yahor-chupin/corvette-c4-raspberry-dashboard/docs/FUEL_DISPLAY_IMPROVEMENT.md

# Fuel Display Improvement - Clean Architecture! 🎯

## ✅ **LATEST UPDATE: GPH Display Fix (January 2025)**

### **Issue Resolved: GPH Multiplication Bug**
Fixed critical issue where GPH values were being multiplied by 10 across different dashboard styles, causing incorrect displays (e.g., showing "8.0 GPH" instead of "0.8 GPH").

### **Root Cause**
Different dashboard styles handle decimal display formatting differently:
- **Synthwave & Corvette C4**: Use direct value passing to display functions
- **Citroën BX, Nissan 300ZX, Subaru XT**: Use display functions that multiply by 10 for decimal formatting

### **Solution Implemented**
Created style-specific GPH display functions that bypass the multiplication issue:

#### **New GPH Display Functions**
```python
def draw_bx_gph_display(surface, gph_value, label, rect):
    """Draw GPH display using Synthwave method (no multiplication)"""
    # Uses direct value passing to draw_dsi_multi_digit_display

def draw_zx_gph_display(surface, gph_value, label, rect):
    """Draw GPH display using Synthwave method (no multiplication)"""
    # Uses direct value passing to draw_dsi_multi_digit_display

def draw_xt_gph_display(surface, gph_value, label, rect):
    """Draw GPH display using Synthwave method (no multiplication)"""
    # Uses direct value passing to draw_dsi_multi_digit_display
```

#### **Updated Style Implementations**
- **Citroën BX**: Now uses `draw_bx_gph_display()` for correct GPH display
- **Nissan 300ZX**: Now uses `draw_zx_gph_display()` for correct GPH display  
- **Subaru XT**: Now uses `draw_xt_gph_display()` for correct GPH display
- **Synthwave & Corvette C4**: Continue using existing compensation method

### **Result**
✅ All dashboard styles now correctly display GPH values (e.g., "0.8 GPH" when idling)
✅ No more incorrect multiplication causing inflated fuel consumption readings
✅ Consistent behavior across all 5 dashboard styles

---

## Changes Made

### 🔧 **Arduino Code Changes** (`arduino_code.cpp`)

#### **1. Simplified Data Flow**
- **Removed complex encoding**: No more `-10.X` encoding for GPH values
- **Direct GPH transmission**: Arduino sends raw `FUEL_FLOW_GPH` value
- **Clean state values**: 
  - `instantMPG = 0.0` → Idling (use GPH display)
  - `instantMPG = -1.0` → Engine off
  - `instantMPG > 0` → Normal MPG display

#### **2. New Serial Output**
Added `FUEL_FLOW_GPH` to the data stream:
```
FUEL_RANGE:245.2,INST_MPG:0.0,AVG_MPG:15.2,FUEL_FLOW_GPH:0.800,AVG_MPG_SW:1,INST_MPG_SW:0,...
```

#### **3. Global Variable Added**
```cpp
float currentFuelFlowGPH = 0.0;   // Current fuel flow in gallons per hour
```

### 🖥️ **Raspberry Pi Changes** (`arduino_combined_dashboard.py`)

#### **1. New Data Parsing**
```python
current_fuel_flow_gph = 0.0  # Current fuel flow in gallons per hour

# In serial parsing:
if "FUEL_FLOW_GPH" in data:
    current_fuel_flow_gph = data["FUEL_FLOW_GPH"]
```

#### **2. Updated Display Logic**
```python
def decode_instant_mpg_display(instant_mpg_value, fuel_flow_gph):
    if instant_mpg_value == 0.0:
        # Engine idling - show GAL/HR
        return {
            'type': 'gph',
            'value': fuel_flow_gph,
            'label': 'GAL/HR',
            'format_decimals': 1
        }
```

#### **3. Improved DSI Display**
- **Label**: Changed from "GPH" to "GAL/HR" (more descriptive)
- **Data source**: Uses direct `current_fuel_flow_gph` instead of decoded values
- **Font size**: Adjusted to fit "GAL/HR" label properly

## Benefits of New Architecture ✅

### **1. Cleaner Data Flow**
```
Arduino: Calculate GPH → Send FUEL_FLOW_GPH:0.800
Raspberry Pi: Receive 0.800 → Display "0.8 GAL/HR"
```

### **2. No More Encoding/Decoding**
- **Before**: `instantMPG = -10.8` → decode to `0.8 GPH`
- **After**: `FUEL_FLOW_GPH = 0.8` → display `0.8 GAL/HR`

### **3. Better Separation of Concerns**
- **Arduino**: Sensor reading and calculations
- **Raspberry Pi**: Display logic and formatting

### **4. More Accurate Display**
- **Direct fuel flow data**: No conversion errors
- **Proper precision**: 3 decimal places in transmission, 1 in display
- **Clear labeling**: "GAL/HR" instead of ambiguous "GPH"

## Expected Results 🎯

### **When Idling** (RPM > 500, Speed = 0):
- **Arduino sends**: `INST_MPG:0.0,FUEL_FLOW_GPH:0.800`
- **Dashboard shows**: `0.8 GAL/HR` (instead of previous `0.04 GPH`)

### **When Driving** (RPM > 500, Speed > 1):
- **Arduino sends**: `INST_MPG:18.5,FUEL_FLOW_GPH:2.400`
- **Dashboard shows**: `18.5 MPG`

### **When Engine Off** (RPM < 500):
- **Arduino sends**: `INST_MPG:-1.0,FUEL_FLOW_GPH:0.000`
- **Dashboard shows**: `OFF`

## Testing Instructions 🧪

### **1. Upload Arduino Code**
```bash
# Upload the updated arduino_code.cpp to Arduino
```

### **2. Restart Dashboard**
```bash
sudo systemctl restart dashboard
```

### **3. Test Scenarios**
1. **Engine Off**: Should show "OFF"
2. **Engine Idling**: Should show "0.8 GAL/HR" (not 0.04)
3. **Driving**: Should show normal MPG values

### **4. Monitor Serial Output**
```bash
# Connect to Arduino serial monitor
# Look for: FUEL_FLOW_GPH:0.800 (when idling)
# Should match dashboard display
```

## Troubleshooting 🔧

### **If Still Showing Wrong Values**:
1. **Check Arduino serial output**: Verify `FUEL_FLOW_GPH` values
2. **Check dashboard parsing**: Look for parsing errors in console
3. **Verify RPM readings**: Ensure RPM > 500 for idling detection

### **Expected Serial Output When Idling**:
```
SPEED:0.0,FUEL:67.3,OIL:42.1,COOLANT:185.0,OILTEMP:200.0,RPM:750,BATTERY:12.6,BRIGHTNESS:85.0,FUEL_CONSUMPTION:4.800
FUEL_RANGE:245.2,INST_MPG:0.0,AVG_MPG:15.2,FUEL_FLOW_GPH:0.800,AVG_MPG_SW:1,INST_MPG_SW:0,...
```

## Architecture Improvement Summary 📊

| Aspect | Before | After | Improvement |
|---|---|---|---|
| **Data Encoding** | Complex `-10.X` encoding | Direct GPH values | ✅ Simplified |
| **Parsing Logic** | Decode negative values | Parse positive values | ✅ Cleaner |
| **Display Accuracy** | Potential conversion errors | Direct data display | ✅ More accurate |
| **Code Maintainability** | Complex encoding logic | Straightforward data flow | ✅ Easier to maintain |
| **Label Clarity** | "GPH" (ambiguous) | "GAL/HR" (clear) | ✅ Better UX |

---

## Status: ✅ **ARCHITECTURE IMPROVED**

The fuel consumption display now uses a clean, direct data flow architecture that should resolve the display accuracy issues and provide clearer, more maintainable code! 🚗⚡
