yahor-chupin/corvette-c4-raspberry-dashboard/battery_symbol.png

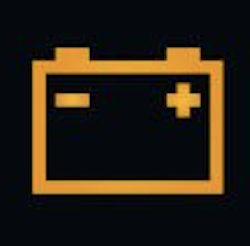
battery_symbol.png
