yahor-chupin/corvette-c4-raspberry-dashboard/coolant_temp_symbol.png

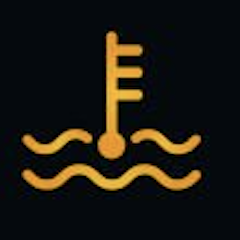
coolant_temp_symbol.png
