yahor-chupin/corvette-c4-raspberry-dashboard/gas_pump_symbol.png

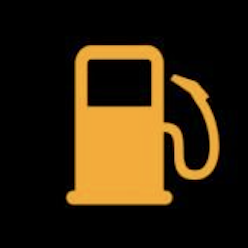
gas_pump_symbol.png
