yahor-chupin/corvette-c4-raspberry-dashboard/oil_symbol.png

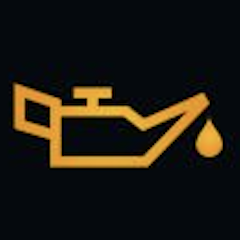
oil_symbol.png
