yahor-chupin/corvette-c4-raspberry-dashboard/arduino_combined_dashboard.py

import pygame
import serial
import math
import time
import os
import subprocess
import json
import signal
import sys
from datetime import datetime

print("THIS IS A DEBUG MESSAGE 1")
# Remove window positioning to match temp_debug_with_grid.py
# os.environ['SDL_VIDEO_WINDOW_POS'] = '-1024,0'  # DISABLED - was preventing center screen access

# Configure SDL for Raspberry Pi displays
os.environ['DISPLAY'] = ':0'  # Use X11 display
os.environ['SDL_VIDEODRIVER'] = 'x11'  # Use X11 for multi-head support

pygame.init()
pygame.mixer.quit()  # Disable audio to stop ALSA errors

# Extended window to include all three screens side by side
TOTAL_WIDTH = 5000  # Increased width to prevent tachometer clipping
SCREEN_HEIGHT = 768  # Keep original height (DSI is 480 but we'll handle rotation)
SINGLE_SCREEN_WIDTH = 1024

# Dashboard style system
current_style_index = 0
STYLE_SYNTHWAVE = 0
STYLE_CITROEN_BX = 1
STYLE_SUBARU_XT = 2
STYLE_NISSAN_300ZX = 3
STYLE_CORVETTE_C4 = 4

# Citroën BX style colors (futuristic dark green)
BX_GREEN = (0, 255, 100)      # Bright futuristic green
BX_DARK_GREEN = (0, 150, 60)  # Darker green for backgrounds
BX_DIM_GREEN = (0, 100, 40)   # Dimmed green for inactive elements
BX_BLACK = (0, 20, 10)        # Very dark green-tinted black

# Subaru XT style colors (amber/orange theme)
XT_AMBER = (255, 191, 0)       # Bright amber
XT_DARK_AMBER = (200, 120, 0)  # Darker amber for backgrounds
XT_DIM_AMBER = (150, 90, 0)    # Dimmed amber for inactive elements
XT_BLACK = (20, 15, 0)         # Very dark amber-tinted black

# Nissan 300ZX style colors (futuristic glowing turquoise theme)
ZX_BLACK = (0, 10, 15)        # Dark blue-tinted black background
ZX_TURQUOISE = (0, 255, 255)  # Bright glowing turquoise
ZX_BRIGHT_TURQUOISE = (100, 255, 255)  # Even brighter for active elements
ZX_DIM_TURQUOISE = (0, 150, 150)      # Dimmed turquoise for inactive elements
ZX_DARK_TURQUOISE = (0, 100, 100)     # Darker turquoise for backgrounds
DSI_SCREEN_WIDTH = 800
DSI_SCREEN_HEIGHT = 480
DSI_X_OFFSET = 2048  # DSI screen starts after both HDMI screens

# Check if fullscreen mode is requested (default to fullscreen for dashboard)
fullscreen_mode = os.environ.get('COMBINED_FULLSCREEN', '1') == '1'  # Default to '1' (fullscreen)

if fullscreen_mode:
    # Use borderless window spanning all screens at position (0,0)
    screen = pygame.display.set_mode((TOTAL_WIDTH, SCREEN_HEIGHT), pygame.NOFRAME)
    print("Combined dashboard started in BORDERLESS FULLSCREEN mode")
else:
    screen = pygame.display.set_mode((TOTAL_WIDTH, SCREEN_HEIGHT))
    print("Combined dashboard started in WINDOWED mode")
    print("Instructions: Press F11 for fullscreen")

pygame.display.set_caption("C4 Dual Dashboard - Combined")
pygame.mouse.set_visible(False)  # Hide mouse cursor for dashboard
clock = pygame.time.Clock()

# Track fullscreen state
is_fullscreen = fullscreen_mode

# Create surfaces for each dashboard (will be rotated)
speedometer_surface = pygame.Surface((1024, 768))
tachometer_surface = pygame.Surface((1024, 968))  # Increased height by 200px total for odometer space

# Load symbol images
try:
    coolant_temp_symbol = pygame.image.load("coolant_temp_symbol.png")
    oil_symbol = pygame.image.load("oil_symbol.png")
    gas_pump_symbol = pygame.image.load("gas_pump_symbol.png")
    battery_symbol = pygame.image.load("battery_symbol.png")
    print("Symbol images loaded successfully")
except Exception as e:
    print(f"Warning: Could not load symbol images: {e}")
    coolant_temp_symbol = None
    oil_symbol = None
    gas_pump_symbol = None
    battery_symbol = None

# Colors
BLACK = (0, 0, 0)
BRIGHT_GREEN = (0, 255, 0)
DULL_GREEN = (0, 100, 0)
YELLOW = (255, 255, 0)
NEON_PINK = (255, 20, 147)
NEON_CYAN = (0, 255, 255)
PURPLE = (138, 43, 226)
ORANGE = (255, 165, 0)
RED = (255, 0, 0)

# SPEEDOMETER PARAMETERS - ADJUSTED UP FOR BETTER SYNTHWAVE POSITIONING
SPEEDO_X_OFFSET = 350
SPEEDO_Y_OFFSET = 480  # Moved up for better Synthwave layout (was 550, now 480, -70px up)
SPEEDO_LENGTH = 350
SPEEDO_DIGITAL_X = 550
SPEEDO_DIGITAL_Y = 320  # Moved up for better Synthwave layout (was 390, now 320, -70px up)
SPEEDO_NUMBER_DISTANCE = 50
SPEEDO_GRID_X = 650
SPEEDO_GRID_Y = 180  # Moved up for better Synthwave layout (was 250, now 180, -70px up)

# TACHOMETER PARAMETERS - ADJUSTED FOR EXPANDED SURFACE (MOVED MORE DOWN)
TACHO_X_OFFSET = 350
TACHO_Y_OFFSET = 550  # Moved down more (was 520, now 550, +30px down)
TACHO_LENGTH = 350
TACHO_DIGITAL_X = 550
TACHO_DIGITAL_Y = 590  # Moved down more (was 560, now 590, +30px down)
TACHO_NUMBER_DISTANCE = 50
TACHO_GRID_X = 650
TACHO_GRID_Y = 430  # Moved down more (was 400, now 430, +30px down)

# Arduino Serial Configuration
SERIAL_BAUD = 115200  # 12x faster serial communication for ultra-low latency
SERIAL_TIMEOUT = 0.1  # Reliable timeout for stable connection

# Auto-detect Arduino port
def find_arduino_port():
    """Automatically find Arduino serial port"""
    import serial.tools.list_ports
    
    # Common Arduino ports to try first
    common_ports = ['/dev/ttyACM0', '/dev/ttyACM1', '/dev/ttyUSB0', '/dev/ttyUSB1']
    
    # Get all available ports
    available_ports = [port.device for port in serial.tools.list_ports.comports()]
    
    # Try common ports first
    for port in common_ports:
        if port in available_ports:
            try:
                test_ser = serial.Serial(port, SERIAL_BAUD, timeout=1)
                test_ser.close()
                print(f"Found Arduino on {port}")
                return port
            except:
                continue
    
    # Try other available ports
    for port in available_ports:
        if port not in common_ports:
            try:
                test_ser = serial.Serial(port, SERIAL_BAUD, timeout=1)
                test_ser.close()
                print(f"Found Arduino on {port}")
                return port
            except:
                continue
    
    return None

SERIAL_PORT = find_arduino_port() or '/dev/ttyACM0'  # Fallback to default

# Persistent Data Management
PERSISTENT_DATA_FILE = "corvette_persistent_data.json"

class PersistentDataManager:
    def __init__(self):
        self.data = {
            "total_odometer": 89240.5,  # Current odometer reading
            "trip_odometer": 0.0,
            "fuel_used": 0.0,
            "fuel_used_bpw": 0.0,  # Real-time fuel consumption tracking
            "dashboard_style": 0,  # 0=Synthwave, 1=Citroën BX
            "last_updated": datetime.now().isoformat(),
            "save_count": 0
        }
        self.load_data()
    
    def load_data(self):
        """Load persistent data from JSON file"""
        try:
            if os.path.exists(PERSISTENT_DATA_FILE):
                with open(PERSISTENT_DATA_FILE, 'r') as f:
                    loaded_data = json.load(f)
                    self.data.update(loaded_data)
                print(f"Loaded persistent data: Total ODO: {self.data['total_odometer']:.1f} miles, "
                      f"Trip: {self.data['trip_odometer']:.1f} miles")
            else:
                print("No existing persistent data file found, starting with defaults")
                self.save_data()
        except Exception as e:
            print(f"Error loading persistent data: {e}")
    
    def save_data(self):
        """Save persistent data to JSON file"""
        try:
            self.data["last_updated"] = datetime.now().isoformat()
            self.data["save_count"] += 1
            
            # Create backup every 1000 saves
            if self.data["save_count"] % 1000 == 0:
                backup_file = f"{PERSISTENT_DATA_FILE}.backup_{int(time.time())}"
                if os.path.exists(PERSISTENT_DATA_FILE):
                    import shutil
                    shutil.copy2(PERSISTENT_DATA_FILE, backup_file)
                    print(f"Created backup: {backup_file}")
            
            with open(PERSISTENT_DATA_FILE, 'w') as f:
                json.dump(self.data, f, indent=2)
            
        except Exception as e:
            print(f"Error saving persistent data: {e}")
    
    def update_data(self, total_odo, trip_odo, fuel_used, fuel_used_bpw=0.0):
        """Update and save persistent data"""
        # Check if data has changed significantly to avoid excessive disk writes
        odo_changed = abs(self.data["total_odometer"] - total_odo) >= 0.1  # Save if odometer changed by 0.1+ miles
        trip_changed = abs(self.data["trip_odometer"] - trip_odo) >= 0.1   # Save if trip changed by 0.1+ miles
        fuel_changed = abs(self.data["fuel_used"] - fuel_used) >= 0.01     # Save if fuel changed by 0.01+ gallons
        bpw_changed = abs(self.data["fuel_used_bpw"] - fuel_used_bpw) >= 0.01  # Save if BPW fuel changed by 0.01+ gallons
        
        # Always update the data in memory
        self.data["total_odometer"] = total_odo
        self.data["trip_odometer"] = trip_odo
        self.data["fuel_used"] = fuel_used
        self.data["fuel_used_bpw"] = fuel_used_bpw
        
        # Only save to disk if significant change occurred
        if odo_changed or trip_changed or fuel_changed or bpw_changed:
            self.save_data()
    
    def send_init_data(self, ser):
        """Send initialization data to Arduino"""
        if ser and ser.is_open:
            try:
                init_message = f"INIT_DATA:{self.data['fuel_used']:.4f},{self.data['fuel_used_bpw']:.4f}\n"
                ser.write(init_message.encode())
                # Init data sent to Arduino
                
                # Also send calculated average MPG
                total_fuel_used = self.data["fuel_used"] + self.data["fuel_used_bpw"]
                if total_fuel_used > 0.01 and self.data["trip_odometer"] > 0.01:
                    avg_mpg = self.data["trip_odometer"] / total_fuel_used
                    if avg_mpg > 50.0:
                        avg_mpg = 50.0
                    mpg_message = f"AVG_MPG_UPDATE:{avg_mpg:.1f}\n"
                    ser.write(mpg_message.encode())
                else:
                    ser.write(b"AVG_MPG_UPDATE:0.0\n")
            except Exception as e:
                print(f"Error sending init data: {e}")

# Initialize persistent data manager
persistent_data = PersistentDataManager()

# Button timing variables
button_trip_start_time = 0
button_avg_start_time = 0
button_combo_start_time = 0
button_trip_triggered = False
button_avg_triggered = False
button_combo_triggered = False
BUTTON_HOLD_TIME = 1000  # 1 second in milliseconds

def handle_button_timing(trip_pressed, avg_pressed):
    """Handle button timing logic in Raspberry Pi"""
    global button_trip_start_time, button_avg_start_time, button_combo_start_time
    global button_trip_triggered, button_avg_triggered, button_combo_triggered
    global current_style_index
    
    current_time = pygame.time.get_ticks()
    
    # Check for combo (both buttons pressed)
    if trip_pressed and avg_pressed:
        if button_combo_start_time == 0:
            button_combo_start_time = current_time
            button_combo_triggered = False
        elif current_time - button_combo_start_time >= BUTTON_HOLD_TIME and not button_combo_triggered:
            # Style change
            old_style = current_style_index
            current_style_index = (current_style_index + 1) % 5
            style_names = {STYLE_SYNTHWAVE: 'Synthwave', STYLE_CITROEN_BX: 'Citroën BX', STYLE_SUBARU_XT: 'Subaru XT', STYLE_NISSAN_300ZX: 'Nissan 300ZX', STYLE_CORVETTE_C4: 'Corvette C4'}
            print(f"🎨 STYLE CHANGE! Changed from {style_names[old_style]} to: {style_names[current_style_index]}")
            
            # Save the new style
            persistent_data.data["dashboard_style"] = current_style_index
            persistent_data.save_data()
            print(f"💾 Style saved: {current_style_index}")
            
            button_combo_triggered = True
    else:
        # Reset combo ONLY when BOTH buttons are released (not when only one is pressed)
        if not trip_pressed and not avg_pressed:
            if button_combo_start_time > 0:
                button_combo_start_time = 0
                button_combo_triggered = False
        
        # Handle individual buttons only when combo is not active
        
        # Trip reset button
        if trip_pressed:
            if button_trip_start_time == 0:
                button_trip_start_time = current_time
                button_trip_triggered = False
            elif current_time - button_trip_start_time >= BUTTON_HOLD_TIME and not button_trip_triggered:
                # Reset trip
                persistent_data.data["trip_odometer"] = 0.0
                persistent_data.save_data()
                print("🔄 TRIP RESET!")
                button_trip_triggered = True
        else:
            button_trip_start_time = 0
            button_trip_triggered = False
        
        # Average reset button
        if avg_pressed:
            if button_avg_start_time == 0:
                button_avg_start_time = current_time
                button_avg_triggered = False
            elif current_time - button_avg_start_time >= BUTTON_HOLD_TIME and not button_avg_triggered:
                # Reset average (would need to send command to Arduino)
                print("🔄 AVERAGE RESET!")
                button_avg_triggered = True
        else:
            button_avg_start_time = 0
            button_avg_triggered = False

# Load saved dashboard style
if "dashboard_style" in persistent_data.data:
    current_style_index = persistent_data.data["dashboard_style"]
    print(f"🎨 Loaded saved style: {'Synthwave' if current_style_index == STYLE_SYNTHWAVE else 'Citroën BX'}")
else:
    # Default to Synthwave if no saved style
    current_style_index = STYLE_SYNTHWAVE
    persistent_data.data["dashboard_style"] = current_style_index

# Initialize serial connection
try:
    ser = serial.Serial(SERIAL_PORT, SERIAL_BAUD, timeout=SERIAL_TIMEOUT)
    print(f"Connected to Arduino on {SERIAL_PORT}")
    serial_connected = True
    # Send initialization data to Arduino
    persistent_data.send_init_data(ser)
except Exception as e:
    print(f"Failed to connect to Arduino: {e}")
    print("Running in demo mode...")
    serial_connected = False
    ser = None

# Simple connection tracking
was_ever_connected = serial_connected

# Current values
current_speed = 0.0
current_rpm = 0.0
demo_rpm_direction = 1

# Adaptive RPM smoothing - fast for large changes, smooth for small oscillations
display_rpm = 0.0  # Smoothed RPM for visual display
RPM_FAST_SMOOTHING = 0.9    # Even faster response for large changes (>50 RPM difference) - increased from 0.85
RPM_SLOW_SMOOTHING = 0.3    # Faster smoothing for small oscillations - increased from 0.25
RPM_DEADBAND = 50           # Much larger deadband for rock-solid idle stability - increased from 35
last_rpm_time = 0           # Track when we last received RPM data

# Speed aggregation system - rolling average for stability
display_speed = 0.0         # Smoothed speed for visual display
speed_samples = []          # Rolling buffer of speed samples
SPEED_SAMPLE_WINDOW = 500   # 500ms aggregation window
MAX_SAMPLES = 25            # Maximum samples in buffer (500ms / 20ms = 25 samples at 50Hz)
last_speed_update = 0       # Track when we last updated display speed
last_speed_time = 0         # Track when we last received speed data

# Software brightness control
software_brightness = 1.0  # 1.0 = full brightness, 0.2 = minimum
last_brightness_value = -1  # Track last brightness to avoid unnecessary updates

# Arduino sensor data (for 3rd dashboard)
current_fuel_level = 50.0
current_oil_pressure = 40.0
current_coolant_temp = 185.0
current_oil_temp = 200.0
current_battery_voltage = 12.6
current_brightness = 75.0
current_fuel_consumption_lbhr = 0.0  # Real-time fuel consumption from ALDL (lb/hr)

# Arduino trip/MPG data (MISSING - this was the bug!)
current_fuel_range = 0.0
current_inst_mpg = 0.0
current_avg_mpg = 0.0
current_fuel_flow_gph = 0.0  # Current fuel flow in gallons per hour

# Distance calculation now done by Raspberry Pi (better persistence)
last_speed_update_time = 0
distance_calculation_initialized = False

# Arduino switch states (for gauge switching)
switch_oil_pressure = False
switch_oil_temp = False
switch_coolant_temp = False
switch_volts = False
switch_fuel_range = False
switch_trip_odo = False
switch_inst_mpg = False
switch_avg_mpg = False
switch_metric = False

# Button states for visual feedback
button_trip_reset = False
button_avg_reset = False

# Speedometer configuration
max_speed = 85
speed_tick_count = 18
speed_numbers = [5, 15, 25, 35, 45, 55, 65, 75, 85]

# Tachometer configuration (matching original Corvette pattern)
max_rpm = 6000  # RPM x100 (60 = 6000 RPM)
rpm_numbers = [0, 1000, 2000, 3000, 4000, 5000, 6000]  # Major numbered ticks

# 7-segment display patterns
SEGMENTS = {
    0: [1,1,1,1,1,1,0],  # a,b,c,d,e,f,g
    1: [0,1,1,0,0,0,0],
    2: [1,1,0,1,1,0,1],
    3: [1,1,1,1,0,0,1],
    4: [0,1,1,0,0,1,1],
    5: [1,0,1,1,0,1,1],
    6: [1,0,1,1,1,1,1],
    7: [1,1,1,0,0,0,0],
    8: [1,1,1,1,1,1,1],
    9: [1,1,1,1,0,1,1]
}

# Metric conversion functions
def mph_to_kph(mph):
    """Convert MPH to KPH"""
    return mph * 1.60934

def fahrenheit_to_celsius(f):
    """Convert Fahrenheit to Celsius"""
    return (f - 32) * 5.0/9.0

def psi_to_kpa(psi):
    """Convert PSI to kPa"""
    return psi * 6.89476

def miles_to_km(miles):
    """Convert miles to kilometers"""
    return miles * 1.60934

def mpg_to_lp100km(mpg):
    """Convert MPG to L/100km (liters per 100 kilometers)"""
    if mpg <= 0:
        return 999.9  # Invalid/infinite consumption
    return 235.214 / mpg  # Standard conversion formula

def decode_instant_mpg_display(instant_mpg_value, fuel_flow_gph=0.0, apply_compensation=True):
    """Decode instant MPG value from Arduino and return display info"""
    if instant_mpg_value == 0.0:
        # Engine idling - show GPH using real fuel flow data
        gph_value = fuel_flow_gph if fuel_flow_gph > 0.01 else 0.8  # Use real data or fallback
        # Only apply division compensation for Synthwave and Corvette C4 styles
        final_value = gph_value / 10.0 if apply_compensation else gph_value
        return {
            'type': 'gph',
            'value': final_value,
            'label': 'GPH',
            'format_decimals': 1
        }
    elif instant_mpg_value == -1.0:
        # Engine off
        return {
            'type': 'off',
            'value': 0,
            'label': 'OFF',
            'format_decimals': 0
        }
    else:
        # Normal MPG display (positive values)
        return {
            'type': 'mpg',
            'value': instant_mpg_value,
            'label': 'MPG',
            'format_decimals': 1
        }

# Reconnection logic removed - was causing blocking issues

def apply_software_brightness(surface, brightness_factor):
    """Apply software brightness by creating a dark overlay"""
    if brightness_factor >= 1.0:
        return  # No dimming needed
    
    # Create a dark overlay
    overlay = pygame.Surface(surface.get_size())
    overlay.fill(BLACK)
    
    # Calculate alpha for overlay (higher alpha = darker)
    alpha = int((1.0 - brightness_factor) * 255)
    overlay.set_alpha(alpha)
    
    # Blit the overlay onto the surface
    surface.blit(overlay, (0, 0))

def set_screen_brightness(brightness_percent):
    """Set brightness for all three screens based on percentage (20-100, never completely dark)"""
    try:
        # Ensure minimum brightness of 20% for safety
        brightness_percent = max(brightness_percent, 20.0)
        
        # Convert percentage to brightness values for different display types
        # Wayland displays: 0.2 to 1.0 (gamma correction approach)
        wayland_brightness = 0.2 + ((brightness_percent - 20.0) / 80.0) * 0.8
        
        # DSI display: 51 to 255 (backlight range, minimum ~20%)
        dsi_brightness = int(51 + ((brightness_percent - 20.0) / 80.0) * 204)
        
        # Fast DSI brightness control (most reliable)
        backlight_paths = [
            '/sys/class/backlight/rpi_backlight/brightness',
            '/sys/class/backlight/10-0045/brightness',
            '/sys/class/backlight/backlight/brightness'
        ]
        
        for path in backlight_paths:
            if os.path.exists(path):
                try:
                    with open(path, 'w') as f:
                        f.write(str(dsi_brightness))
                    break  # Success, no need to try other paths
                except (PermissionError, OSError):
                    continue
        
        # DISABLED: xrandr calls were causing dashboard freezing
        # Try xrandr for Wayland displays (skip if too slow)
        # wayland_outputs = ['XWAYLAND0', 'XWAYLAND1']  # Only try first two (speedometer/tachometer)
        # 
        # for output in wayland_outputs:
        #     try:
        #         # Quick xrandr call with minimal output
        #         subprocess.run(['xrandr', '--output', output, '--brightness', str(wayland_brightness)], 
        #                       capture_output=True, timeout=0.1, check=False)
        #     except (subprocess.TimeoutExpired, Exception):
        #         # Skip if too slow or fails
        #         continue
                    
    except Exception:
        # Silently ignore errors to avoid slowing down the main loop
        pass

def read_arduino_data():
    """Read speed, RPM, and sensor data from Arduino"""
    global current_speed, current_rpm, demo_rpm_direction
    global current_fuel_level, current_oil_pressure, current_coolant_temp, current_oil_temp
    global current_battery_voltage, current_brightness
    global display_rpm, last_rpm_time
    global display_speed, last_speed_time
    global switch_oil_pressure, switch_oil_temp, switch_coolant_temp, switch_volts
    global switch_fuel_range, switch_trip_odo, switch_inst_mpg, switch_avg_mpg, switch_metric
    global current_fuel_range, current_inst_mpg, current_avg_mpg, current_fuel_flow_gph
    global last_speed_update_time, distance_calculation_initialized
    global serial_connected, ser
    global speed_samples, last_speed_update  # Added missing global declarations
    
    # Debug timing removed for performance
    
    if not serial_connected:
            # Only show demo if Arduino was NEVER connected from the beginning
            if not was_ever_connected:
                # Demo mode - simulate both speed and RPM changes
                current_speed += 0.4
                if current_speed > 90:
                    current_speed = 0
                    
                current_rpm += 50 * demo_rpm_direction
                if current_rpm >= 6500:
                    demo_rpm_direction = -1
                elif current_rpm <= 800:
                    demo_rpm_direction = 1
                
                # Demo mode for sensor data (will be overridden by DSI demo animations)
                current_fuel_level = 65.0
                current_oil_pressure = 40.0
                current_coolant_temp = 185.0
                current_oil_temp = 200.0
                current_fuel_consumption_lbhr = 2.5  # Demo fuel consumption
                current_fuel_flow_gph = 0.8  # Demo fuel flow
            else:
                # Arduino was connected before but now disconnected - freeze last values
                # Don't update any values, just return current state
                pass
                
            return current_speed, current_rpm
    
    try:
        if ser is None or not ser.is_open:
            raise Exception("Serial connection is not open")
        
        # Simple, reliable serial processing - back to working version
        if ser.in_waiting > 0:
            # If buffer is getting full (>1000 bytes), clear old data
            if ser.in_waiting > 1000:
                ser.reset_input_buffer()  # Clear the buffer
                line = ""
            else:
                line = ser.readline().decode('utf-8', errors='ignore').strip()
        else:
            line = ""  # No data available, don't block
        
        if not line:
            return current_speed, current_rpm
        

        
        # Parse Arduino data
        # Parse the actual format
        # Handle Arduino initialization requests
        if line.startswith("INIT_REQUEST:PERSISTENT_DATA"):
            # print("Arduino requesting persistent data")  # Disabled for performance
            persistent_data.send_init_data(ser)
            return current_speed, current_rpm
        
        # Handle Arduino reset commands
        if line.startswith("RESET_TRIP:"):
            # Reset trip odometer (distance calculation now done by Pi)
            persistent_data.data["trip_odometer"] = 0.0
            persistent_data.save_data()
            # Send reset average MPG to Arduino
            if ser and ser.is_open:
                try:
                    ser.write(b"AVG_MPG_UPDATE:0.0\n")
                except:
                    pass
            # Trip odometer reset by Arduino button
            return current_speed, current_rpm
        
        # Handle style change command (both buttons held for 2+ seconds)
        if line.startswith("STYLE_CHANGE:"):
            global current_style_index
            current_style_index = (current_style_index + 1) % 5  # Cycle between 0, 1, 2, 3, and 4
            
            # Save the new style to persistent data
            persistent_data.data["dashboard_style"] = current_style_index
            persistent_data.save_data()
            
            return current_speed, current_rpm
        

        
        # Handle Arduino save data commands
        if line.startswith("SAVE_DATA:"):
            data_part = line[10:]  # Remove "SAVE_DATA:" prefix
            parts = data_part.split(',')
            if len(parts) >= 1:  # New format: only fuel data (distance calculated by Pi)
                try:
                    fuel_used = float(parts[0])
                    fuel_used_bpw = float(parts[1]) if len(parts) > 1 else 0.0
                    # Update only fuel data, keep existing distance data
                    persistent_data.data["fuel_used"] = fuel_used
                    persistent_data.data["fuel_used_bpw"] = fuel_used_bpw
                    persistent_data.save_data()
                    # print(f"Saved fuel data: {fuel_used:.2f}, {fuel_used_bpw:.2f}")  # Disabled for performance
                except ValueError as e:
                    print(f"Error parsing save data: {e}")
            return current_speed, current_rpm
        
        if "SPEED:" in line or "FUELRNG:" in line or "AMPG_SW:" in line:
            
            # Split by comma and parse key:value pairs (handles both high and low frequency messages)
            pairs = line.split(",")
            data = {}
            for pair in pairs:
                if ":" in pair:
                    key, value = pair.split(":", 1)
                    try:
                        data[key.strip()] = float(value.strip())
                    except ValueError:
                        pass  # Skip non-numeric values
            

            
            # Update speed if available with essential processing restored
            if "SPEED" in data:
                current_speed = data["SPEED"]
                current_time = pygame.time.get_ticks()
                last_speed_time = current_time  # Update timestamp
                
                # Essential distance calculation (simplified from old version)
                if distance_calculation_initialized and last_speed_update_time > 0:
                    delta_time_ms = current_time - last_speed_update_time
                    if delta_time_ms > 0 and current_speed > 0.1:  # Only when moving
                        # Calculate distance increment in miles
                        distance_increment = (current_speed * delta_time_ms) / 3600000.0  # MPH * ms -> miles
                        
                        # Update odometer values
                        persistent_data.data["total_odometer"] += distance_increment
                        persistent_data.data["trip_odometer"] += distance_increment
                        
                        # Calculate average MPG (simplified)
                        total_fuel_used = persistent_data.data["fuel_used"] + persistent_data.data["fuel_used_bpw"]
                        if total_fuel_used > 0.01 and persistent_data.data["trip_odometer"] > 0.01:
                            calculated_avg_mpg = persistent_data.data["trip_odometer"] / total_fuel_used
                            if calculated_avg_mpg > 50.0:
                                calculated_avg_mpg = 50.0
                            current_avg_mpg = calculated_avg_mpg
                        else:
                            current_avg_mpg = 0.0
                
                last_speed_update_time = current_time
                distance_calculation_initialized = True
                
                # Essential speed processing (simplified from old working version)
                display_speed = current_speed  # Simple assignment for now
            else:
                # No speed data in this message - check if we should timeout
                current_time = pygame.time.get_ticks()
                if current_speed is not None and (current_time - last_speed_time) < 500:  # 500ms timeout
                    # Keep last good values - prevents brief gaps during fast serial updates
                    pass
                else:
                    # Timeout exceeded or first time - reset
                    display_speed = 0.0
            
            # Handle RPM data - no simulation when Arduino is connected
            if "RPM" in data:
                current_rpm = data["RPM"]  # Use actual RPM data (including 0 if that's the value)
                last_rpm_time = pygame.time.get_ticks()  # Update timestamp
                
                # Adaptive RPM smoothing - fast for big changes, stable for small ones
                if display_rpm == 0.0:  # First reading
                    display_rpm = current_rpm
                else:
                    rpm_difference = abs(current_rpm - display_rpm)
                    
                    # Deadband: ignore very small changes to prevent 6↔7 oscillation
                    if rpm_difference < RPM_DEADBAND:
                        # Keep current display value - no change for small oscillations
                        pass
                    elif rpm_difference > 50:
                        # Large change: fast response (revving up/down)
                        display_rpm = display_rpm + (current_rpm - display_rpm) * RPM_FAST_SMOOTHING
                    else:
                        # Medium change: normal smoothing
                        display_rpm = display_rpm + (current_rpm - display_rpm) * RPM_SLOW_SMOOTHING
                
                # Debug output disabled for maximum performance
                # print(f"RPM DEBUG: Arduino={data['RPM']}, Smooth={display_rpm:.0f}, Display_calc={int(display_rpm)//100}, Should_show={int(display_rpm)//100:02d}")
            else:
                # No RPM data in this message - check if we should timeout
                current_time = pygame.time.get_ticks()
                if current_rpm is not None and (current_time - last_rpm_time) < 500:  # 500ms timeout
                    # Keep last good values - prevents brief N/A flicker during fast serial updates
                    pass
                else:
                    # Timeout exceeded or first time - show N/A
                    current_rpm = None
                    display_rpm = 0.0
            
            # Update sensor data for 3rd dashboard
            if "FUEL" in data:
                current_fuel_level = data["FUEL"]
            if "OIL" in data:
                current_oil_pressure = data["OIL"]
            if "COOLANT" in data:
                # Arduino now sends Fahrenheit directly, handle special "LO" value
                current_coolant_temp = data["COOLANT"]
            if "OILTEMP" in data:
                # Arduino now sends Fahrenheit directly, handle special "LO" value
                current_oil_temp = data["OILTEMP"]
            if "BATTERY" in data:
                current_battery_voltage = data["BATTERY"]
            if "BRIGHTNESS" in data:
                current_brightness = data["BRIGHTNESS"]
            if "FUEL_CONSUMPTION" in data:
                current_fuel_consumption_lbhr = data["FUEL_CONSUMPTION"]
            
            # Update trip/MPG data (FIXED - this was missing!)
            if "TRIP_ODO" in data:
                current_trip_odo = data["TRIP_ODO"]
            if "TOTAL_ODO" in data:
                current_total_odo = data["TOTAL_ODO"]
            if "FUELRNG" in data:
                current_fuel_range = data["FUELRNG"]
            if "IMPG" in data:
                current_inst_mpg = data["IMPG"]
            if "AMPG" in data:
                current_avg_mpg = data["AMPG"]
            if "FLOW" in data:
                current_fuel_flow_gph = data["FLOW"]

            
            # Update switch states for gauge switching
            if "OIL_P_SW" in data:
                switch_oil_pressure = bool(int(data["OIL_P_SW"]))
            if "OIL_T_SW" in data:
                switch_oil_temp = bool(int(data["OIL_T_SW"]))
            if "COOL_SW" in data:
                switch_coolant_temp = bool(int(data["COOL_SW"]))
            if "VOLT_SW" in data:
                switch_volts = bool(int(data["VOLT_SW"]))
            if "FUELR_SW" in data:
                switch_fuel_range = bool(int(data["FUELR_SW"]))
            if "TRIP_SW" in data:
                switch_trip_odo = bool(int(data["TRIP_SW"]))
            if "IMPG_SW" in data:
                switch_inst_mpg = bool(int(data["IMPG_SW"]))
            if "AMPG_SW" in data:
                switch_avg_mpg = bool(int(data["AMPG_SW"]))
            if "METR_SW" in data:
                switch_metric = bool(int(data["METR_SW"]))
            
            # Handle button states with timing logic
            if "TRIP_BTN" in data and "AVG_BTN" in data:
                trip_btn = bool(int(data["TRIP_BTN"]))
                avg_btn = bool(int(data["AVG_BTN"]))
                
                handle_button_timing(trip_btn, avg_btn)
            
            # Update button states for visual feedback
            if "TRIP_BTN" in data:
                button_trip_reset = bool(int(data["TRIP_BTN"]))
            if "AVG_BTN" in data:
                button_avg_reset = bool(int(data["AVG_BTN"]))
            
            # Handle persistent data communication
            if "TOTAL_ODO" in data and "TRIP_ODO" in data and "FUEL_USED" in data:
                # Update persistent data from Arduino
                persistent_data.update_data(
                    data["TOTAL_ODO"],
                    data["TRIP_ODO"], 
                    data["FUEL_USED"]
                )
            
            # Clean console output
            rpm_display = "N/A" if current_rpm is None else f"{current_rpm:.0f}"
            #print(f"Arduino - Speed: {current_speed:.1f} MPH, RPM: {rpm_display}")
        # Silently ignore other message formats
    except Exception as e:
        if serial_connected:
            # Arduino connection lost - switch to demo mode
            serial_connected = False
            if ser:
                try:
                    ser.close()
                except:
                    pass
                    ser = None
        # print(f"Serial read error: {e}")  # Disabled - connectivity issue resolved
        pass  # Silent error handling for performance
    
    return current_speed, current_rpm

def draw_7_segment_digit(surface, x, y, digit, color, size=50, dim_factor=1.0):
    """Draw a single 7-segment digit with optional dimming for leading zeros"""
    if digit < 0 or digit > 9:
        return
    
    segments = SEGMENTS[digit]
    w, h = size, size * 1.5
    gap = max(2, size // 12)  # Proportional gap (4px for 50px size)
    thickness = max(4, size // 4)  # Proportional thickness (12px for 50px size, 7px for 30px)
    
    # Apply dimming factor to color
    if dim_factor < 1.0:
        dimmed_color = tuple(int(c * dim_factor) for c in color)
    else:
        dimmed_color = color
    
    def draw_horizontal_segment(start_x, start_y, width):
        points = [
            (start_x + thickness//2, start_y - thickness//2),
            (start_x + width - thickness//2, start_y - thickness//2),
            (start_x + width, start_y),
            (start_x + width - thickness//2, start_y + thickness//2),
            (start_x + thickness//2, start_y + thickness//2),
            (start_x, start_y)
        ]
        pygame.draw.polygon(surface, dimmed_color, points)
    
    def draw_vertical_segment(start_x, start_y, height):
        points = [
            (start_x - thickness//2, start_y + thickness//2),
            (start_x, start_y),
            (start_x + thickness//2, start_y + thickness//2),
            (start_x + thickness//2, start_y + height - thickness//2),
            (start_x, start_y + height),
            (start_x - thickness//2, start_y + height - thickness//2)
        ]
        pygame.draw.polygon(surface, dimmed_color, points)
    
    # Draw segments based on pattern
    if segments[0]:  # a (top)
        draw_horizontal_segment(x + gap, y, w - 2*gap)
    if segments[1]:  # b (top right)
        draw_vertical_segment(x + w, y + gap, h//2 - 2*gap)
    if segments[2]:  # c (bottom right)
        draw_vertical_segment(x + w, y + h//2 + gap, h//2 - 2*gap)
    if segments[3]:  # d (bottom)
        draw_horizontal_segment(x + gap, y + h, w - 2*gap)
    if segments[4]:  # e (bottom left)
        draw_vertical_segment(x, y + h//2 + gap, h//2 - 2*gap)
    if segments[5]:  # f (top left)
        draw_vertical_segment(x, y + gap, h//2 - 2*gap)
    if segments[6]:  # g (middle)
        draw_horizontal_segment(x + gap, y + h//2, w - 2*gap)

def draw_multi_digit_display(surface, value, num_digits, start_x, start_y, digit_width, color, size=50, leading_zero_dim=0.3):
    """Draw multi-digit display with dimmed leading zeros"""
    # Format the number with leading zeros
    format_str = f"{{:0{num_digits}d}}"
    value_str = format_str.format(int(value))
    
    # Find first non-zero digit
    first_non_zero = len(value_str)  # Default to end if all zeros
    for i, digit_char in enumerate(value_str):
        if digit_char != '0':
            first_non_zero = i
            break
    
    # Special case: if all digits are zero, dim all but the last one
    if first_non_zero == len(value_str):
        first_non_zero = len(value_str) - 1
    
    # Draw each digit
    for i, digit_char in enumerate(value_str):
        digit = int(digit_char)
        x = start_x + i * digit_width
        
        # Determine if this is a leading zero
        is_leading_zero = (i < first_non_zero and digit == 0)
        dim_factor = leading_zero_dim if is_leading_zero else 1.0
        
        draw_7_segment_digit(surface, x, start_y, digit, color, size, dim_factor)

def draw_speed_display(surface, speed):
    """Draw 3-digit speed in 7-segment style with MPH/KPH label"""
    # Convert to metric if metric switch is active (use aggregated display_speed, not raw speed)
    if switch_metric:
        display_speed_for_drawing = mph_to_kph(display_speed)
        unit_text = "KPH"
    else:
        display_speed_for_drawing = display_speed
        unit_text = "MPH"
    
    digit_width = 80
    start_x = SPEEDO_DIGITAL_X
    start_y = SPEEDO_DIGITAL_Y
    
    # Use multi-digit display with leading zero dimming
    draw_multi_digit_display(surface, display_speed, 3, start_x, start_y, digit_width, YELLOW, 50, 0.3)
    
    font_small = pygame.font.SysFont('Arial', 24, bold=True)
    unit_label = font_small.render(unit_text, True, YELLOW)
    unit_rect = unit_label.get_rect(center=(start_x + digit_width, start_y + 120))
    surface.blit(unit_label, unit_rect)

def draw_rpm_display(surface, rpm):
    """Draw 2-digit RPM in 7-segment style with RPM/100 label"""
    digit_width = 80  # Same spacing as speedometer
    start_x = TACHO_DIGITAL_X - 60   # Moved right for centering (was -100, now -60)
    start_y = TACHO_DIGITAL_Y - 170  # Moved up 70 pixels from previous position (-100 - 70 = -170)
    
    if rpm is None:
        # Show "N/A" when no RPM data is available
        font_na = pygame.font.SysFont('Arial', 40, bold=True)
        na_text = font_na.render("N/A", True, (128, 128, 128))  # Gray color for N/A
        na_rect = na_text.get_rect()
        na_x = start_x + digit_width - na_rect.width // 2  # Center where digits would be
        surface.blit(na_text, (na_x, start_y + 20))
    else:
        # Show RPM digits with leading zero dimming - display actual RPM/100 properly
        rpm_hundreds = int(rpm) // 100  # Convert to hundreds for display (e.g., 741 RPM -> 7, should show as "07")
        # Ensure we show the correct value: 741 RPM should show "07" (meaning 0700 RPM range)
        draw_multi_digit_display(surface, rpm_hundreds, 2, start_x, start_y, digit_width, YELLOW, 50, 0.3)
    
    font_small = pygame.font.SysFont('Arial', 24, bold=True)
    rpm_text = font_small.render("RPM/100", True, YELLOW)  # Changed from "RPM" to "RPM/100"
    rpm_rect = rpm_text.get_rect(center=(start_x + digit_width * 1 - 10, start_y + 105))  # Moved 10 pixels to the left
    surface.blit(rpm_text, rpm_rect)


def draw_odometer_separate(surface, total_miles):
    """Draw odometer on dedicated small surface for high positioning"""
    # Position within small surface (320x70) - WIDER SURFACE
    odo_x = 260  # Adjusted for wider surface (was 240, now 260)
    odo_y = 45   # Lower in surface to leave room for title
    
    # Compact styling for small surface
    digit_width = 28
    digit_height = 35
    digit_spacing = 30
    border_color = (100, 100, 100)
    bg_color = (20, 20, 20)
    digit_color = (255, 255, 255)
    decimal_color = (255, 200, 0)
    
    if total_miles is None or total_miles < 0:
        total_miles = 0.0
    
    # Format odometer
    integer_part = int(total_miles)
    decimal_part = int((total_miles - integer_part) * 10)
    integer_str = f"{integer_part:06d}"
    decimal_str = f"{decimal_part:01d}"
    
    # Draw title at top of surface
    font_title = pygame.font.SysFont('Arial', 14, bold=True)
    title_text = font_title.render("ODOMETER", True, (200, 200, 200))
    surface.blit(title_text, (odo_x - 60, 5))  # Top of surface
    
    # Draw digits
    font_digit = pygame.font.SysFont('Courier', 22, bold=True)
    
    for i, digit_char in enumerate(integer_str):
        x = odo_x - (6 - i) * digit_spacing
        y = odo_y
        
        # Draw digit background and border
        digit_rect = pygame.Rect(x - digit_width//2, y - digit_height//2, digit_width, digit_height)
        pygame.draw.rect(surface, border_color, digit_rect, 2)
        pygame.draw.rect(surface, bg_color, digit_rect.inflate(-4, -4))
        
        # Draw digit
        digit_surface = font_digit.render(digit_char, True, digit_color)
        digit_rect_center = digit_surface.get_rect(center=(x, y))
        surface.blit(digit_surface, digit_rect_center)
    
    # Draw decimal point and digit
    decimal_x = odo_x + digit_spacing
    decimal_y = odo_y + digit_height//4
    pygame.draw.circle(surface, decimal_color, (decimal_x, decimal_y), 3)
    
    decimal_digit_x = odo_x + digit_spacing * 1.3
    decimal_digit_rect = pygame.Rect(decimal_digit_x - digit_width//2, odo_y - digit_height//2, digit_width, digit_height)
    pygame.draw.rect(surface, border_color, decimal_digit_rect, 2)
    pygame.draw.rect(surface, bg_color, decimal_digit_rect.inflate(-4, -4))
    
    decimal_surface = font_digit.render(decimal_str, True, decimal_color)
    decimal_rect_center = decimal_surface.get_rect(center=(decimal_digit_x, odo_y))
    surface.blit(decimal_surface, decimal_rect_center)

def draw_odometer_display(surface, total_miles):
    """Draw 7-digit odometer display in top right corner, similar to original C4 cluster"""
    # Optimized position for all dashboard styles (no title, expanded surface)
    odo_x = 800  # Right side positioning - moved right more (+50 total)
    odo_y = 10   # Top area with expanded surface space - moved up more (-30 total)
    
    # Odometer styling - similar to original C4
    digit_width = 32
    digit_height = 45
    digit_spacing = 35
    border_color = (100, 100, 100)  # Gray border
    bg_color = (20, 20, 20)         # Dark background
    digit_color = (255, 255, 255)   # White digits
    decimal_color = (255, 200, 0)   # Yellow/orange for decimal digit
    
    # Ensure we have a valid number
    if total_miles is None or total_miles < 0:
        total_miles = 0.0
    
    # Format odometer reading: 089240.5 -> "089240" + "5"
    # Split into integer and decimal parts
    integer_part = int(total_miles)
    decimal_part = int((total_miles - integer_part) * 10)  # Get first decimal place
    
    # Format as 6 digits + 1 decimal: "089240" + "5"
    integer_str = f"{integer_part:06d}"  # 6 digits with leading zeros
    decimal_str = f"{decimal_part:01d}"  # 1 decimal digit
    
    # Title removed for cleaner appearance
    
    # Use regular font instead of 7-segment for reliability
    font_digit = pygame.font.SysFont('Courier', 28, bold=True)  # Monospace font
    
    # Draw integer digits (6 digits)
    for i, digit_char in enumerate(integer_str):
        # Calculate position for this digit
        x = odo_x - (6 - i) * digit_spacing  # Right to left positioning
        y = odo_y
        
        # Draw border rectangle
        border_rect = pygame.Rect(x - 2, y - 2, digit_width + 4, digit_height + 4)
        pygame.draw.rect(surface, border_color, border_rect, 2)
        
        # Draw background
        bg_rect = pygame.Rect(x, y, digit_width, digit_height)
        pygame.draw.rect(surface, bg_color, bg_rect)
        
        # Draw the digit using regular font
        digit_text = font_digit.render(digit_char, True, digit_color)
        digit_rect = digit_text.get_rect(center=(x + digit_width//2, y + digit_height//2))
        surface.blit(digit_text, digit_rect)
    
    # Draw decimal point
    decimal_x = odo_x + 5
    decimal_y = odo_y + digit_height - 10
    pygame.draw.circle(surface, decimal_color, (decimal_x, decimal_y), 4)
    
    # Draw decimal digit (1 digit)
    x = odo_x + 15
    y = odo_y
    
    # Draw border rectangle for decimal digit
    border_rect = pygame.Rect(x - 2, y - 2, digit_width + 4, digit_height + 4)
    pygame.draw.rect(surface, border_color, border_rect, 2)
    
    # Draw background for decimal digit
    bg_rect = pygame.Rect(x, y, digit_width, digit_height)
    pygame.draw.rect(surface, bg_color, bg_rect)
    
    # Draw the decimal digit in different color
    decimal_digit_text = font_digit.render(decimal_str, True, decimal_color)
    decimal_digit_rect = decimal_digit_text.get_rect(center=(x + digit_width//2, y + digit_height//2))
    surface.blit(decimal_digit_text, decimal_digit_rect)

def draw_synthwave_mountains(surface, rpm):
    """Draw minimalist mountain and sunset scene with color based on RPM"""
    # Scale down by 30% and position at top left of dashboard
    scale_factor = 0.7  # 30% smaller
    center_x = 275      # Moved right from 250 to 275
    center_y = 200      # Moved down significantly - 2.5x mountain height (~125px * 2.5 = ~312, using 200 for balance)
    scene_width = int(280 * scale_factor)  # Scaled width
    scene_height = int(120 * scale_factor)  # Scaled height
    
    def interpolate_color(color1, color2, factor):
        return tuple(int(c1 + (c2 - c1) * factor) for c1, c2 in zip(color1, color2))
    
    # Handle None RPM case
    if rpm is None:
        # No RPM data - use default colors
        mountain_color = NEON_CYAN  # Default cyan color
        sun_color = BLACK  # Invisible sun
    else:
        # Mountain color (same progression as grid)
        if rpm <= 3000:
            factor = rpm / 3000.0
            mountain_color = interpolate_color(NEON_CYAN, PURPLE, factor)
        else:
            factor = min((rpm - 3000) / 4000.0, 1.0)
            mountain_color = interpolate_color(PURPLE, RED, factor)
        
        # Sun color progression (black -> cyan -> yellow)
        if rpm <= 1500:
            # Low RPM: black (invisible)
            sun_factor = rpm / 1500.0
            sun_color = interpolate_color(BLACK, NEON_CYAN, sun_factor)
        elif rpm <= 4500:
            # Mid RPM: cyan -> yellow
            sun_factor = (rpm - 1500) / 3000.0
            sun_color = interpolate_color(NEON_CYAN, YELLOW, sun_factor)
        else:
            # High RPM: bright yellow
            sun_color = YELLOW
    
    # Draw simple geometric mountains and sun like in the image
    import math
    
    # Base line for mountains (scaled)
    base_y = center_y + scene_height - int(10 * scale_factor)
    
    # Right mountain (background, scaled)
    right_base_left = center_x - int(20 * scale_factor)
    right_base_right = center_x + int(120 * scale_factor)
    right_peak_x = center_x + int(50 * scale_factor)
    right_peak_y = center_y + int(10 * scale_factor)
    
    # Left mountain (foreground, scaled)
    left_base_left = center_x - int(130 * scale_factor)
    left_base_right = center_x + int(30 * scale_factor)
    left_peak_x = center_x - int(50 * scale_factor)
    left_peak_y = center_y - int(10 * scale_factor)
    
    # Create duller colors for fills (reduce intensity by ~40%)
    def make_duller(color):
        return tuple(int(c * 0.6) for c in color)
    
    mountain_fill_color = make_duller(mountain_color)
    sun_fill_color = make_duller(sun_color) if sun_color != BLACK else BLACK
    
    # Draw bigger sun (behind both mountains) - stretched horizontally and scaled
    sun_center_x = center_x
    sun_center_y = center_y + int(30 * scale_factor)
    sun_radius_x = 87.5 * scale_factor  # Scaled horizontal radius
    sun_radius_y = 70 * scale_factor    # Scaled vertical radius
    
    # Draw filled sun ellipse with gradient (behind mountains)
    if sun_color != BLACK:  # Only draw if visible
        # Draw gradient fill by drawing horizontal lines from top to bottom
        sun_top = sun_center_y - sun_radius_y
        sun_bottom = sun_center_y + sun_radius_y
        
        for y in range(int(sun_top), int(sun_bottom) + 1):
            # Calculate how far down we are (0.0 at top, 1.0 at bottom)
            gradient_factor = (y - sun_top) / (sun_bottom - sun_top)
            
            # Create 8-bit style bands (quantize the gradient into discrete steps)
            num_bands = 6  # Number of color bands for 8-bit effect
            band_index = int(gradient_factor * num_bands)
            if band_index >= num_bands:
                band_index = num_bands - 1
            
            # Use the band index to create discrete color steps
            band_factor = band_index / (num_bands - 1)
            
            # Interpolate between bright sun color at top and darker at bottom
            bright_color = sun_color
            dark_color = make_duller(make_duller(sun_color))  # Extra dark (36% of original)
            
            gradient_color = tuple(
                int(bright_color[i] * (1 - band_factor) + dark_color[i] * band_factor)
                for i in range(3)
            )
            
            # Calculate the width of the ellipse at this y position
            if abs(y - sun_center_y) <= sun_radius_y:
                # Ellipse equation: (x-cx)²/rx² + (y-cy)²/ry² = 1
                # Solve for x: x = cx ± rx * sqrt(1 - (y-cy)²/ry²)
                y_offset = y - sun_center_y
                width_factor = math.sqrt(1 - (y_offset / sun_radius_y) ** 2)
                half_width = sun_radius_x * width_factor
                
                start_x = int(sun_center_x - half_width)
                end_x = int(sun_center_x + half_width)
                
                # Draw horizontal line with gradient color
                if start_x <= end_x:
                    pygame.draw.line(surface, gradient_color, (start_x, y), (end_x, y), 1)
        
        # Draw sun outline
        for angle in range(0, 360, 3):
            start_angle = math.radians(angle)
            end_angle = math.radians(angle + 3)
            
            start_x = sun_center_x + sun_radius_x * math.cos(start_angle)
            start_y = sun_center_y + sun_radius_y * math.sin(start_angle)
            end_x = sun_center_x + sun_radius_x * math.cos(end_angle)
            end_y = sun_center_y + sun_radius_y * math.sin(end_angle)
            
            pygame.draw.line(surface, sun_color, (start_x, start_y), (end_x, end_y), 2)
    
    # Draw mountains in correct order (back to front)
    # Right mountain first (background)
    right_mountain_points = [
        (right_base_left, base_y),
        (right_peak_x, right_peak_y),
        (right_base_right, base_y)
    ]
    
    # Draw filled right mountain
    pygame.draw.polygon(surface, mountain_fill_color, right_mountain_points)
    
    # Draw right mountain outline
    pygame.draw.line(surface, mountain_color, (right_base_left, base_y), (right_peak_x, right_peak_y), 2)  # Left side
    pygame.draw.line(surface, mountain_color, (right_peak_x, right_peak_y), (right_base_right, base_y), 2)  # Right side
    pygame.draw.line(surface, mountain_color, (right_base_left, base_y), (right_base_right, base_y), 2)  # Base
    
    # Left mountain second (foreground, covers part of right mountain)
    left_mountain_points = [
        (left_base_left, base_y),
        (left_peak_x, left_peak_y),
        (left_base_right, base_y)
    ]
    
    # Draw filled left mountain
    pygame.draw.polygon(surface, mountain_fill_color, left_mountain_points)
    
    # Draw left mountain outline
    pygame.draw.line(surface, mountain_color, (left_base_left, base_y), (left_peak_x, left_peak_y), 2)  # Left side
    pygame.draw.line(surface, mountain_color, (left_peak_x, left_peak_y), (left_base_right, base_y), 2)  # Right side
    pygame.draw.line(surface, mountain_color, (left_base_left, base_y), (left_base_right, base_y), 2)  # Base

def draw_diagonal_speedometer(surface, current_speed):
    """Draw curved diagonal speedometer with horizontal ticks"""
    line_start_x = SPEEDO_X_OFFSET
    line_start_y = SPEEDO_Y_OFFSET
    line_length = SPEEDO_LENGTH
    angle_deg = 60
    angle_rad = math.radians(angle_deg)
    
    line_end_x = line_start_x + line_length * math.cos(angle_rad)
    line_end_y = line_start_y - line_length * math.sin(angle_rad)
    
    # Convert speed and scale for metric if needed (use aggregated display_speed, not raw current_speed)
    if switch_metric:
        display_speed_for_drawing = mph_to_kph(display_speed)
        max_display_speed = mph_to_kph(max_speed)  # ~137 KPH
        display_numbers = [int(mph_to_kph(mph)) for mph in speed_numbers]  # Convert speed numbers to KPH
    else:
        display_speed_for_drawing = display_speed
        max_display_speed = max_speed
        display_numbers = speed_numbers
    
    for i in range(speed_tick_count):
        mph = (i / (speed_tick_count - 1)) * max_speed  # Always use original MPH for tick positioning
        display_mph = (i / (speed_tick_count - 1)) * max_display_speed  # Display value (MPH or KPH)
        ratio = i / (speed_tick_count - 1)
        
        curve_intensity = 80
        curve_offset = math.sin(ratio * math.pi) * curve_intensity
        
        base_tick_x = line_start_x + ratio * (line_end_x - line_start_x)
        base_tick_y = line_start_y + ratio * (line_end_y - line_start_y)
        
        tick_x = base_tick_x - curve_offset
        tick_y = base_tick_y
        
        is_numbered_tick = any(abs(mph - num) < 2.5 for num in speed_numbers)
        
        # Horizontal tick line
        if is_numbered_tick:
            tick_length = 120
            tick_x1 = tick_x - tick_length/2 - 40
            tick_x2 = tick_x + tick_length/2
        else:
            tick_length = 120
            tick_x1 = tick_x - tick_length/2
            tick_x2 = tick_x + tick_length/2
        
        tick_y1 = tick_y
        tick_y2 = tick_y
        
        color = BRIGHT_GREEN if mph < current_speed else DULL_GREEN
        pygame.draw.line(surface, color, (tick_x1, tick_y1), (tick_x2, tick_y2), 16)
        
        if is_numbered_tick:
            closest_num = min(speed_numbers, key=lambda x: abs(x - mph))
            if abs(mph - closest_num) < 2.5:
                font_number = pygame.font.SysFont('Arial', 30, bold=True)
                # Display the converted number
                if switch_metric:
                    display_num = int(mph_to_kph(closest_num))
                else:
                    display_num = closest_num
                
                # Dim numbers when not reached, bright when reached (like tachometer)
                if closest_num <= current_speed:
                    number_color = YELLOW  # Bright when reached
                else:
                    number_color = (100, 100, 0)  # Dimmed yellow when not reached
                
                number_text = font_number.render(str(display_num), True, number_color)
                number_x = tick_x1 - SPEEDO_NUMBER_DISTANCE
                number_y = tick_y - 12
                surface.blit(number_text, (number_x, number_y))

def get_modified_tachometer_position(rpm):
    """Calculate position along smoothed mountain-shaped RPM line with linear x-spacing"""
    
    # Starting point (bottom left)
    line_start_x = TACHO_X_OFFSET - 120
    line_start_y = TACHO_Y_OFFSET
    
    # End point (bottom right) - extended length for wider ticks spacing
    line_end_x = TACHO_X_OFFSET + 400  # Extended from 350 to 400 for wider tick spacing
    line_end_y = TACHO_Y_OFFSET
    
    # Peak at 4500 RPM (75% along the line)
    peak_rpm = 4500
    peak_ratio = peak_rpm / max_rpm  # 0.75
    
    # Linear x-coordinate progression (equal spacing)
    ratio = rpm / max_rpm
    tick_x = line_start_x + ratio * (line_end_x - line_start_x)
    
    # Y-coordinate follows mountain shape with peak at 4500 RPM - more vertical stretch
    if rpm <= peak_rpm:
        # Rising part: 0 to peak at 4500 RPM
        segment_ratio = rpm / peak_rpm
        # Sharper rise to peak with more height
        peak_height = 280  # Increased from 200 for more vertical stretch
        # Use a sharper curve (power function instead of sine)
        tick_y = line_start_y - (segment_ratio ** 0.7 * peak_height)
    else:
        # Falling part: 4500 to 6000 RPM
        segment_ratio = (rpm - peak_rpm) / (max_rpm - peak_rpm)
        # Sharper fall from peak
        peak_height = 280
        fall_height = 60  # Increased fall for more dramatic curve
        # Use sharper curve for the fall
        tick_y = line_start_y - peak_height + (segment_ratio ** 0.8 * fall_height)
    
    return tick_x, tick_y

def draw_modified_tachometer(surface, current_rpm):
    """Draw modified tachometer following exact original Corvette C4 pattern"""
    
    # Generate ticks with equal spacing along the RPM line
    # Total of 26 ticks based on your pattern, equally spaced from 0 to 6000 RPM
    
    all_ticks = []
    total_ticks = 26
    
    for i in range(total_ticks):
        # Equal RPM spacing from 0 to 6000
        rpm = (i / (total_ticks - 1)) * max_rpm
        
        # Determine color based on RPM ranges from your specification
        if rpm <= 4000:  # 0-40 (0-4000 RPM): green
            active_color = BRIGHT_GREEN
            inactive_color = DULL_GREEN
        elif rpm <= 4500:  # 40-45 (4000-4500 RPM): green (starting to fall)
            active_color = BRIGHT_GREEN
            inactive_color = DULL_GREEN
        elif rpm <= 5000:  # 45-50 (4500-5000 RPM): yellow
            active_color = YELLOW
            inactive_color = (100, 100, 0)
        else:  # 50-60 (5000-6000 RPM): mix of yellow and red
            if rpm <= 5400:  # First part yellow
                active_color = YELLOW
                inactive_color = (100, 100, 0)
            else:  # Last part red
                active_color = RED
                inactive_color = (100, 0, 0)
        
        all_ticks.append((rpm, active_color, inactive_color))
    
    # Draw all ticks
    for i, (rpm, active_color, inactive_color) in enumerate(all_ticks):
        # Stop at 6000 RPM exactly
        if rpm > 6000:
            continue
            
        tick_x, tick_y = get_modified_tachometer_position(rpm)
        
        # Determine if this is a major numbered tick (0, 1000, 2000, 3000, 4000, 5000, 6000)
        # Calculate which ticks should be numbered based on exact positions
        numbered_tick_indices = []
        for target_rpm in rpm_numbers:
            target_index = round((target_rpm / max_rpm) * (total_ticks - 1))
            numbered_tick_indices.append(target_index)
        
        is_numbered_tick = i in numbered_tick_indices
        
        # All ticks have same length (constant thickness and spacing) - 20% longer
        base_tick_length = 72  # Increased from 60 to 72 (20% longer)
        
        # Adjust length based on curve geometry to maintain visual consistency
        curve_position = rpm / max_rpm
        if curve_position <= 0.2:  # Start of curve
            tick_length = base_tick_length + 24  # Increased from 20 to 24 (20% longer)
        elif curve_position <= 0.75:  # Middle ascending part (up to peak at 4500)
            tick_length = base_tick_length + 12  # Increased from 10 to 12 (20% longer)
        else:  # Descending part after peak
            tick_length = base_tick_length - 6  # Increased from -5 to -6 (20% longer)
        
        # All ticks same length - no longer ticks for numbered points
        tick_y1 = tick_y - tick_length/2
        tick_y2 = tick_y + tick_length/2
        
        # Color based on current RPM (handle None case)
        if current_rpm is None:
            # No RPM data - show all ticks as inactive
            color = inactive_color
        else:
            # Normal RPM comparison
            if rpm <= current_rpm:
                color = active_color
            else:
                color = inactive_color
        
        # Draw tick with increased thickness (15% wider than speedometer)
        pygame.draw.line(surface, color, (tick_x, tick_y1), (tick_x, tick_y2), 18)  # 15% wider than speedometer (16 * 1.15 = 18)
        
        # Draw small square and RPM numbers for major ticks
        if is_numbered_tick:
            # Draw small square on top of tick - same width as tick (18 pixels)
            square_size = 18  # Same as new tick thickness (15% wider)
            square_x = tick_x - square_size // 2
            square_y = tick_y1 - square_size - 3  # Above the tick
            
            square_color = color  # Same color as the tick
            pygame.draw.rect(surface, square_color, (square_x, square_y, square_size, square_size))
            
            # Draw RPM number above the square
            font_number = pygame.font.SysFont('Arial', 24, bold=True)
            
            # Find which numbered RPM this tick represents based on tick index
            target_rpm = rpm_numbers[numbered_tick_indices.index(i)]
            display_num = str(int(target_rpm // 1000))
            
            # Show numbers based on current RPM (handle None case)
            if current_rpm is None:
                number_color = (80, 80, 0)  # Dim when no data
            else:
                number_color = YELLOW if rpm <= current_rpm else (80, 80, 0)
            
            number_text = font_number.render(display_num, True, number_color)
            number_rect = number_text.get_rect()
            number_x = square_x + square_size // 2 - number_rect.width // 2  # Center above square
            number_y = square_y - number_rect.height - 5  # Above the square
            surface.blit(number_text, (number_x, number_y))

def draw_synthwave_grid(surface, value, is_speed=True, grid_x=650, grid_y=180):
    """Draw synthwave grid with color based on speed or RPM"""
    max_width = 280
    min_width = 60
    
    def interpolate_color(color1, color2, factor):
        return tuple(int(c1 + (c2 - c1) * factor) for c1, c2 in zip(color1, color2))
    
    if is_speed:
        # Speed-based colors (0-40 mph: cyan->purple, 40-85 mph: purple->red)
        if value <= 40:
            factor = value / 40.0
            color = interpolate_color(NEON_CYAN, PURPLE, factor)
        else:
            factor = min((value - 40) / 45.0, 1.0)
            color = interpolate_color(PURPLE, RED, factor)
    else:
        # RPM-based colors (0-3000 rpm: cyan->purple, 3000-7000 rpm: purple->red)
        if value <= 3000:
            factor = value / 3000.0
            color = interpolate_color(NEON_CYAN, PURPLE, factor)
        else:
            factor = min((value - 3000) / 4000.0, 1.0)
            color = interpolate_color(PURPLE, RED, factor)
    
    # Horizontal perspective lines
    for i in range(8):
        y_pos = grid_y + (i * 15)
        width_factor = (i + 1) / 8.0
        line_width = int(min_width + (max_width - min_width) * width_factor)
        
        start_x = grid_x - line_width // 2
        end_x = grid_x + line_width // 2
        
        pygame.draw.line(surface, color, (start_x, y_pos), (end_x, y_pos), 2)
    
    # Vertical perspective lines
    for i in range(-3, 4):
        if i == 0:
            continue
        
        start_x = grid_x + i * 8
        start_y = grid_y - 15
        end_x = grid_x + i * 35
        end_y = grid_y + 120
        
        pygame.draw.line(surface, color, (start_x, start_y), (end_x, end_y), 2)

def draw_connection_status(surface, x_offset=10):
    """Draw connection status indicator"""
    status_font = pygame.font.SysFont('Arial', 16, bold=True)
    if serial_connected:
        # No status display when connected (user doesn't want distraction)
        pass
    else:
        if was_ever_connected:
            status_text = status_font.render("ARDUINO DISCONNECTED", True, RED)
        else:
            status_text = status_font.render("DEMO MODE", True, YELLOW)
        surface.blit(status_text, (x_offset, 10))

def draw_diagonal_speedometer_smooth(surface, current_speed):
    """Draw curved diagonal line with smooth bar filling - Corvette C4 version"""
    # Calculated geometry (same as original speedometer)
    line_start_x = SPEEDO_X_OFFSET
    line_start_y = SPEEDO_Y_OFFSET
    line_length = SPEEDO_LENGTH
    angle_deg = 60
    angle_rad = math.radians(angle_deg)
    
    line_end_x = line_start_x + line_length * math.cos(angle_rad)
    line_end_y = line_start_y - line_length * math.sin(angle_rad)
    
    # Draw the curved path as a thick smooth filled bar with flat ends
    bar_thickness = 80  # Even thicker for speedometer (was 60, now 80)
    
    # Calculate how much of the bar to fill based on current speed
    speed_ratio = min(current_speed / max_speed, 1.0)
    
    # Draw the background curve (full length, dimmed)
    for i in range(speed_tick_count * 8):  # More points for smoother curve
        ratio = i / (speed_tick_count * 8 - 1)
        
        # Create a curved path
        curve_intensity = 80
        curve_offset = math.sin(ratio * math.pi) * curve_intensity
        
        # Position along the diagonal line with curve
        base_x = line_start_x + ratio * (line_end_x - line_start_x)
        base_y = line_start_y + ratio * (line_end_y - line_start_y)
        
        # Apply curve offset
        center_x = base_x - curve_offset
        center_y = base_y
        
        # Draw background segment as horizontal rectangle following curve direction
        rect_width = bar_thickness
        rect_height = bar_thickness // 5  # Even thinner height for less boxy appearance
        rect = pygame.Rect(int(center_x - rect_width//2), int(center_y - rect_height//2), 
                          rect_width, rect_height)
        pygame.draw.rect(surface, DULL_GREEN, rect)
    
    # Draw the filled portion (up to current speed)
    fill_points = int(speed_tick_count * 8 * speed_ratio)
    for i in range(fill_points):
        ratio = i / (speed_tick_count * 8 - 1)
        
        # Create a curved path
        curve_intensity = 80
        curve_offset = math.sin(ratio * math.pi) * curve_intensity
        
        # Position along the diagonal line with curve
        base_x = line_start_x + ratio * (line_end_x - line_start_x)
        base_y = line_start_y + ratio * (line_end_y - line_start_y)
        
        # Apply curve offset
        center_x = base_x - curve_offset
        center_y = base_y
        
        # Draw filled segment as horizontal rectangle following curve direction
        rect_width = bar_thickness
        rect_height = bar_thickness // 5  # Even thinner height for less boxy appearance
        rect = pygame.Rect(int(center_x - rect_width//2), int(center_y - rect_height//2), 
                          rect_width, rect_height)
        pygame.draw.rect(surface, BRIGHT_GREEN, rect)
    
    # Draw horizontal black grid lines - milestone positions + intermediate lines
    # First draw milestone grid lines (matching milestone positions)
    for speed_num in speed_numbers:
        # Calculate position along the curve (same as milestone calculation)
        ratio = speed_num / max_speed
        curve_intensity = 80
        curve_offset = math.sin(ratio * math.pi) * curve_intensity
        
        base_x = line_start_x + ratio * (line_end_x - line_start_x)
        base_y = line_start_y + ratio * (line_end_y - line_start_y)
        
        grid_x = base_x - curve_offset
        grid_y = base_y
        
        # Draw horizontal black grid line through the whole bar at milestone level
        grid_line_left = grid_x - bar_thickness  # Extend beyond bar left
        grid_line_right = grid_x + bar_thickness  # Extend beyond bar right
        pygame.draw.line(surface, BLACK, 
                        (int(grid_line_left), int(grid_y)), 
                        (int(grid_line_right), int(grid_y)), 2)
    
    # Add intermediate grid lines (2 lines between each milestone)
    for i in range(len(speed_numbers) - 1):
        current_speed_num = speed_numbers[i]
        next_speed_num = speed_numbers[i + 1]
        
        # Add 2 intermediate lines between current and next milestone
        for j in range(1, 3):  # j = 1, 2 (two intermediate lines)
            intermediate_speed = current_speed_num + (next_speed_num - current_speed_num) * (j / 3.0)
            
            # Calculate position for intermediate grid line
            ratio = intermediate_speed / max_speed
            curve_intensity = 80
            curve_offset = math.sin(ratio * math.pi) * curve_intensity
            
            base_x = line_start_x + ratio * (line_end_x - line_start_x)
            base_y = line_start_y + ratio * (line_end_y - line_start_y)
            
            grid_x = base_x - curve_offset
            grid_y = base_y
            
            # Draw intermediate grid line (slightly thinner)
            grid_line_left = grid_x - bar_thickness  # Extend beyond bar left
            grid_line_right = grid_x + bar_thickness  # Extend beyond bar right
            pygame.draw.line(surface, BLACK, 
                            (int(grid_line_left), int(grid_y)), 
                            (int(grid_line_right), int(grid_y)), 1)  # Thinner line for intermediate
    
    # Draw horizontal milestone lines and speed numbers at key positions
    for speed_num in speed_numbers:
        # Calculate position along the curve
        ratio = speed_num / max_speed
        curve_intensity = 80
        curve_offset = math.sin(ratio * math.pi) * curve_intensity
        
        base_x = line_start_x + ratio * (line_end_x - line_start_x)
        base_y = line_start_y + ratio * (line_end_y - line_start_y)
        
        tick_x = base_x - curve_offset
        tick_y = base_y
        
        # Draw horizontal milestone line starting to the left of the bar with spacing
        line_start_x_pos = tick_x - bar_thickness // 2 - 15  # Reduced gap from bar (was 30px, now 15px)
        line_end_x_pos = tick_x - 80  # Extend leftward
        pygame.draw.line(surface, YELLOW if speed_num <= current_speed else (100, 100, 0), 
                        (int(line_start_x_pos), int(tick_y)), (int(line_end_x_pos), int(tick_y)), 3)
        
        # Draw speed numbers (both reached and dimmed unreached)
        # Position number with much more spacing from milestone line
        number_x = tick_x - 150  # Much more spacing from milestone line (was 130, now 150)
        number_y = tick_y - 12
        
        font_number = pygame.font.SysFont('Arial', 30, bold=True)
        
        # Color based on whether speed is reached (like tachometer)
        if speed_num <= current_speed:
            number_color = YELLOW  # Bright when reached
        else:
            number_color = (100, 100, 0)  # Dimmed yellow when not reached
        
        number_text = font_number.render(str(speed_num), True, number_color)
        surface.blit(number_text, (number_x, number_y))

def draw_modified_tachometer_smooth(surface, rpm):
    """Draw RPM-to-power curve tachometer with smooth bar filling - Corvette C4 version"""
    # Use the same mountain-shaped curve as original Synthwave tachometer
    bar_thickness = 60  # Much thicker (was 20, now 60)
    
    # Calculate how much of the curve to fill based on current RPM
    # Safety check for None values
    if rpm is None or rpm == 0:
        rpm = 0
    rpm_ratio = min(rpm / max_rpm, 1.0)
    
    # Draw the background curve (full length, dimmed)
    total_points = 500  # Much more points for smoother curve (was 200, now 500)
    for i in range(total_points):
        point_rpm = (i / (total_points - 1)) * max_rpm
        tick_x, tick_y = get_modified_tachometer_position(point_rpm)
        
        # Draw background segment as vertical rectangle following curve direction
        rect_width = bar_thickness // 5  # Even thinner width for less boxy appearance (was //3, now //5)
        rect_height = bar_thickness
        rect = pygame.Rect(int(tick_x - rect_width//2), int(tick_y - rect_height//2), 
                          rect_width, rect_height)
        
        # Color background to match filled bar progression but dimmed
        if point_rpm <= 4000:
            bg_color = DULL_GREEN  # Dimmed green
        elif point_rpm <= 4500:
            bg_color = DULL_GREEN  # Dimmed green
        elif point_rpm <= 5000:
            bg_color = (100, 100, 0)  # Dimmed yellow
        else:
            if point_rpm <= 5400:
                bg_color = (100, 100, 0)  # Dimmed yellow
            else:
                bg_color = (100, 0, 0)  # Dimmed red
        
        pygame.draw.rect(surface, bg_color, rect)
    
    # Draw the filled portion (up to current RPM)
    fill_points = int(total_points * rpm_ratio)
    for i in range(fill_points):
        point_rpm = (i / (total_points - 1)) * max_rpm
        tick_x, tick_y = get_modified_tachometer_position(point_rpm)
        
        # Choose color based on RPM (same as original)
        if point_rpm <= 4000:
            fill_color = BRIGHT_GREEN
        elif point_rpm <= 4500:
            fill_color = BRIGHT_GREEN
        elif point_rpm <= 5000:
            fill_color = YELLOW
        else:
            if point_rpm <= 5400:
                fill_color = YELLOW
            else:
                fill_color = RED
        
        # Draw filled segment as vertical rectangle following curve direction
        rect_width = bar_thickness // 5  # Even thinner width for less boxy appearance (was //3, now //5)
        rect_height = bar_thickness
        rect = pygame.Rect(int(tick_x - rect_width//2), int(tick_y - rect_height//2), 
                          rect_width, rect_height)
        pygame.draw.rect(surface, fill_color, rect)
    
    # Draw vertical black grid lines on the bar for visual separation
    grid_spacing = 20  # Grid line every 20 points along the curve
    for i in range(0, total_points, grid_spacing):
        grid_rpm = (i / (total_points - 1)) * max_rpm
        grid_x, grid_y = get_modified_tachometer_position(grid_rpm)
        
        # Draw vertical black grid line through the whole bar
        grid_line_top = grid_y - bar_thickness  # Extend beyond bar top
        grid_line_bottom = grid_y + bar_thickness  # Extend beyond bar bottom
        pygame.draw.line(surface, BLACK, 
                        (int(grid_x), int(grid_line_top)), 
                        (int(grid_x), int(grid_line_bottom)), 2)
    
    # Draw milestone vertical lines and numbers at key positions
    for rpm_num in rpm_numbers:
        tick_x, tick_y = get_modified_tachometer_position(rpm_num)
        
        # Draw vertical milestone line starting above the bar with more spacing
        line_start_y = tick_y - bar_thickness // 2 - 20  # Start above curve with 20px spacing (was 10px)
        line_end_y = tick_y - 80  # Extend upward (shorter line)
        pygame.draw.line(surface, YELLOW if rpm_num <= rpm else (100, 100, 0), 
                        (int(tick_x), int(line_start_y)), (int(tick_x), int(line_end_y)), 3)
        
        # Draw RPM numbers (both reached and dimmed unreached)
        # Position number higher above the curve
        number_x = tick_x
        number_y = tick_y - 100  # Moved up from -40 to -100
        
        # Draw number (show as x1000 format)
        display_num = int(rpm_num / 1000)
        font_number = pygame.font.SysFont('Arial', 24, bold=True)
        
        # Color based on whether RPM is reached (like other styles)
        if rpm_num <= rpm:
            number_color = YELLOW  # Bright when reached
        else:
            number_color = (100, 100, 0)  # Dimmed yellow when not reached
        
        number_text = font_number.render(str(display_num), True, number_color)
        text_rect = number_text.get_rect(center=(number_x, number_y))
        surface.blit(number_text, text_rect)

def draw_redline_warning(surface, rpm):
    """Draw redline warning positioned under RPM/100 with 80s style font"""
    if rpm is not None and rpm > 4500:  # Show warning after 4500 RPM (only if RPM data available)
        # Position under RPM/100 label
        # Calculate position based on RPM display positioning
        start_x = TACHO_DIGITAL_X - 60
        start_y = TACHO_DIGITAL_Y - 170 + 105 + 40  # Below RPM/100 label
        
        # 80s style font - use a bold, blocky font (50% larger)
        warning_font = pygame.font.SysFont('Courier', 42, bold=True)  # Increased from 28 to 42 (50% larger)
        
        # Color based on RPM level
        if rpm > 5500:
            # Red after 5500 RPM with pulsing effect
            pulse = abs(math.sin(pygame.time.get_ticks() * 0.015)) * 0.3 + 0.7  # Faster pulse, less dramatic
            warning_color = (int(255 * pulse), 0, 0)
        else:
            # Yellow after 4500 RPM
            warning_color = YELLOW
        
        warning_text = warning_font.render("REDLINE", True, warning_color)
        
        # Position the text (moved 25 pixels to the right)
        text_rect = warning_text.get_rect()
        text_x = start_x + 40 - text_rect.width // 2 + 25  # Moved 25 pixels to the right
        
        surface.blit(warning_text, (text_x, start_y))

def draw_rounded_rect_border(surface, color, rect, radius, thickness=3):
    """Draw a simple rectangular border"""
    pygame.draw.rect(surface, color, rect, thickness)

def draw_dsi_7_segment_digit(surface, x, y, digit, color, size=30, dim_factor=1.0):
    """Draw a 7-segment digit specifically sized for DSI gauges with optional dimming"""
    if digit < 0 or digit > 9:
        return
    
    segments = SEGMENTS[digit]
    w, h = size, size * 1.5
    gap = 2
    thickness = max(6, size // 6)  # Increased thickness for bolder digits (was size//8, now size//6)
    
    # Apply dimming factor to color
    if dim_factor < 1.0:
        dimmed_color = tuple(int(c * dim_factor) for c in color)
    else:
        dimmed_color = color
    
    def draw_horizontal_segment(start_x, start_y, width):
        points = [
            (start_x + thickness//2, start_y - thickness//2),
            (start_x + width - thickness//2, start_y - thickness//2),
            (start_x + width, start_y),
            (start_x + width - thickness//2, start_y + thickness//2),
            (start_x + thickness//2, start_y + thickness//2),
            (start_x, start_y)
        ]
        pygame.draw.polygon(surface, dimmed_color, points)
    
    def draw_vertical_segment(start_x, start_y, height):
        points = [
            (start_x - thickness//2, start_y + thickness//2),
            (start_x, start_y),
            (start_x + thickness//2, start_y + thickness//2),
            (start_x + thickness//2, start_y + height - thickness//2),
            (start_x, start_y + height),
            (start_x - thickness//2, start_y + height - thickness//2)
        ]
        pygame.draw.polygon(surface, dimmed_color, points)
    
    # Draw segments based on pattern
    if segments[0]:  # a (top)
        draw_horizontal_segment(x + gap, y, w - 2*gap)
    if segments[1]:  # b (top right)
        draw_vertical_segment(x + w, y + gap, h//2 - 2*gap)
    if segments[2]:  # c (bottom right)
        draw_vertical_segment(x + w, y + h//2 + gap, h//2 - 2*gap)
    if segments[3]:  # d (bottom)
        draw_horizontal_segment(x + gap, y + h, w - 2*gap)
    if segments[4]:  # e (bottom left)
        draw_vertical_segment(x, y + h//2 + gap, h//2 - 2*gap)
    if segments[5]:  # f (top left)
        draw_vertical_segment(x, y + gap, h//2 - 2*gap)
    if segments[6]:  # g (middle)
        draw_horizontal_segment(x + gap, y + h//2, w - 2*gap)

def draw_dsi_multi_digit_display(surface, value, num_digits, start_x, start_y, digit_spacing, color, size=30, leading_zero_dim=0.3, decimal_pos=None):
    """Draw multi-digit display for DSI gauges with dimmed leading zeros and optional decimal point"""
    
    # Input validation: Handle negative values and special cases
    if value < 0:
        # For negative values, just display zeros (or handle specially)
        value = 0
    
    # Format the number with leading zeros
    try:
        if decimal_pos is not None:
            # Handle decimal formatting (e.g., 000.0 format)
            format_str = f"{{:0{num_digits + 1}.1f}}"
            value_str = format_str.format(float(value)).replace('.', '')
        else:
            # Integer formatting
            format_str = f"{{:0{num_digits}d}}"
            value_str = format_str.format(int(value))
    except (ValueError, TypeError):
        # Fallback: display zeros if formatting fails
        value_str = '0' * num_digits
    
    # Find first non-zero digit
    first_non_zero = len(value_str)  # Default to end if all zeros
    for i, digit_char in enumerate(value_str):
        if digit_char != '0':
            first_non_zero = i
            break
    
    # Special case: if all digits are zero, show the last digit at full brightness
    if first_non_zero == len(value_str):
        first_non_zero = len(value_str) - 1
    
    # Draw each digit
    for i, digit_char in enumerate(value_str):
        try:
            digit = int(digit_char)
        except ValueError:
            # Skip non-numeric characters (shouldn't happen with our validation above)
            continue
        x = start_x + i * digit_spacing
        
        # Add extra space after decimal point position
        if decimal_pos is not None and i >= decimal_pos:
            x += 15
        
        # Determine if this is a leading zero
        is_leading_zero = (i < first_non_zero and digit == 0)
        dim_factor = leading_zero_dim if is_leading_zero else 1.0
        
        draw_dsi_7_segment_digit(surface, x, start_y, digit, color, size, dim_factor)
    
    # Draw decimal point if specified
    if decimal_pos is not None:
        decimal_x = start_x + decimal_pos * digit_spacing + size // 8  # Fine-tuned position between digits
        decimal_y = start_y + int(size * 1.5) - 8
        pygame.draw.circle(surface, color, (decimal_x, decimal_y), 4)

def draw_dsi_screen_content(surface, speed, rpm):
    """Draw C4 Corvette style dashboard for the 3rd DSI screen (800x480)"""
    global current_fuel_level, current_oil_pressure, current_coolant_temp, current_oil_temp
    global switch_oil_pressure, switch_oil_temp, switch_coolant_temp, switch_volts
    global switch_fuel_range, switch_trip_odo, switch_inst_mpg, switch_avg_mpg, switch_metric
    

    # Use the passed surface directly (should be 800x480 landscape)
    dsi_surface = surface
    
    # Fonts matching the main dashboard
    font_large = pygame.font.SysFont('Arial', 32, bold=True)  # For titles
    font_medium = pygame.font.SysFont('Arial', 24, bold=True)  # For labels
    font_small = pygame.font.SysFont('Arial', 18, bold=True)   # For small text
    font_digits = pygame.font.SysFont('Arial', 36, bold=True)  # For digital displays
    
    # Colors matching main dashboard
    border_color = YELLOW
    text_color = YELLOW
    digit_color = YELLOW
    
    # Layout dimensions (scaled up by 30% + 15% more = 49.5% total)
    gauge_width = int(180 * 1.495)  # 269
    gauge_height = int(120 * 1.495)  # 179
    margin = 20
    corner_radius = 10
    
    # Adjusted margins to bring gauges closer to center for physical window fit
    top_margin = 70    # Original working position for Synthwave style (reverted to original)
    bottom_margin = 80  # Increased to move bottom gauges UP and prevent cutoff
    
    # === 1. GAUGE 1 (Top Left) - Oil Pressure or Oil Temperature ===
    oil_rect = (margin, top_margin, gauge_width, gauge_height)
    draw_rounded_rect_border(dsi_surface, border_color, oil_rect, corner_radius, 3)
    
    # Determine which gauge to show based on switch states
    time_ms = pygame.time.get_ticks()
    
    if switch_oil_pressure:
        # Show Oil Pressure Gauge
        if serial_connected:
            oil_pressure = current_oil_pressure  # Use real Arduino data
        elif not was_ever_connected:
            oil_pressure = 40 + math.sin(time_ms * 0.0003) * 40  # Demo: 0-80 PSI (only if never connected)
        else:
            oil_pressure = current_oil_pressure  # Use last known value when disconnected
        
        # Convert pressure for metric display and warning logic
        pressure_kpa = psi_to_kpa(oil_pressure)
        
        # Determine display pressure and unit
        if switch_metric:
            display_pressure = pressure_kpa
            pressure_unit = "kPa"
        else:
            display_pressure = oil_pressure
            pressure_unit = "PSI"
        
        # Warning light for low oil pressure (between PSI/kPa and digits)
        if switch_metric:
            warning_light_active = pressure_kpa < psi_to_kpa(5)  # Convert 5 PSI threshold to kPa
        else:
            warning_light_active = oil_pressure < 5
        if warning_light_active:
            # Blinking red rectangular warning light - same height as digits
            # Stay on most of the time, off briefly
            blink_time = pygame.time.get_ticks() // 200  # Faster cycle (200ms)
            if blink_time % 5 != 0:  # Show light 4 out of 5 cycles (80% on, 20% off)
                digit_height = int(44 * 1.5)  # Same height as 7-segment digits
                warning_rect = (oil_rect[0] + 80, oil_rect[1] + 40, 25, digit_height)
                pygame.draw.rect(dsi_surface, RED, warning_rect, 0)
        
        # Pressure unit label (left side)
        pressure_text = font_medium.render(pressure_unit, True, text_color)
        dsi_surface.blit(pressure_text, (oil_rect[0] + 15, oil_rect[1] + 35))
        
        # Oil pressure digits (right side) - 7-segment display with leading zero dimming
        digit_size = int(35 * 1.25)  # 44 (25% larger)
        digit_spacing = int(40 * 1.5)  # 60 (50% more spacing)
        start_x = oil_rect[0] + gauge_width - 3 * digit_spacing - 15
        start_y = oil_rect[1] + 40
        
        draw_dsi_multi_digit_display(dsi_surface, display_pressure, 3, start_x, start_y, digit_spacing, digit_color, digit_size, 0.3)
        
        # "OIL PRESS" label and oil symbol (bottom)
        oil_label = font_small.render("OIL PRESS", True, text_color)
        oil_label_rect = oil_label.get_rect()
        dsi_surface.blit(oil_label, (oil_rect[0] + (gauge_width - oil_label_rect.width) // 2, oil_rect[1] + gauge_height - 35))
        
        # Oil symbol from PNG
        if oil_symbol:
            symbol_x = oil_rect[0] + (gauge_width - oil_label_rect.width) // 2 - 45  # Moved further left
            symbol_y = oil_rect[1] + gauge_height - 55  # Moved up
            # Scale the symbol to appropriate size (about 40x40 pixels - 2x larger)
            scaled_symbol = pygame.transform.scale(oil_symbol, (40, 40))
            dsi_surface.blit(scaled_symbol, (symbol_x, symbol_y))
        else:
            # Fallback: Simple oil can symbol (rectangle with spout)
            oil_can_x = oil_rect[0] + (gauge_width - oil_label_rect.width) // 2 - 25
            oil_can_y = oil_rect[1] + gauge_height - 30
            pygame.draw.rect(dsi_surface, text_color, (oil_can_x, oil_can_y, 12, 16), 2)
            pygame.draw.rect(dsi_surface, text_color, (oil_can_x + 12, oil_can_y + 2, 6, 4), 2)
    
    elif switch_oil_temp:
        # Show Oil Temperature Gauge
        if serial_connected:
            oil_temp = current_oil_temp  # Use real Arduino data
        elif not was_ever_connected:
            oil_temp = 115 + math.sin(time_ms * 0.0002) * 135  # Demo: -20 to +250°F (only if never connected)
        else:
            oil_temp = current_oil_temp  # Use last known value when disconnected
        
        # Convert temperature for metric display and warning logic
        oil_temp_celsius = fahrenheit_to_celsius(oil_temp)
        

        
        # Determine display temperature and unit
        if switch_metric:
            display_oil_temp = oil_temp_celsius
            temp_unit = "°C"
        else:
            display_oil_temp = oil_temp
            temp_unit = "°F"
        
        # Warning light for high oil temperature (between digits and °F/°C)
        if switch_metric:
            warning_light_active = oil_temp_celsius > fahrenheit_to_celsius(250)  # Convert 250°F threshold to °C
        else:
            warning_light_active = oil_temp > 250
        if warning_light_active:
            # Blinking red rectangular warning light - same height as digits
            # Stay on most of the time, off briefly
            blink_time = pygame.time.get_ticks() // 200  # Faster cycle (200ms)
            if blink_time % 5 != 0:  # Show light 4 out of 5 cycles (80% on, 20% off)
                digit_height = int(44 * 1.5)  # Same height as 7-segment digits
                warning_rect = (oil_rect[0] + gauge_width - 80, oil_rect[1] + 40, 25, digit_height)
                pygame.draw.rect(dsi_surface, RED, warning_rect, 0)
        
        # Oil temperature digits (left side) - handle "LO" temperature or normal display
        if display_oil_temp <= -999:  # Special "LO" temperature value from Arduino
            # Display "LO" like original C4 cluster
            lo_font = pygame.font.SysFont('Arial', 48, bold=True)
            lo_text = lo_font.render("LO", True, digit_color)
            lo_rect = lo_text.get_rect()
            dsi_surface.blit(lo_text, (oil_rect[0] + 30, oil_rect[1] + 35))
        else:
            # Normal temperature display - 7-segment display with negative sign support and leading zero dimming
            temp_value = int(display_oil_temp)
            is_negative = temp_value < 0
            abs_temp = abs(temp_value)
            
            digit_size = int(35 * 1.25)  # 44 (25% larger)
            digit_spacing = int(40 * 1.5)  # 60 (50% more spacing)
            # Adjust start position to make room for negative sign
            base_start_x = oil_rect[0] + 15
            start_x = base_start_x + (25 if is_negative else 0)  # Move digits right if negative
            start_y = oil_rect[1] + 40
            
            # Draw negative sign if temperature is negative
            if is_negative:
                minus_font = pygame.font.SysFont('Arial', 32, bold=True)  # Larger font for longer minus
                minus_text = minus_font.render("−", True, digit_color)  # Using proper minus symbol (longer)
                dsi_surface.blit(minus_text, (base_start_x + 5, start_y + 12))  # Positioned before digits
            
            draw_dsi_multi_digit_display(dsi_surface, abs_temp, 3, start_x, start_y, digit_spacing, digit_color, digit_size, 0.3)
        
        # Temperature unit symbol (right side)
        temp_symbol = font_medium.render(temp_unit, True, text_color)
        temp_symbol_rect = temp_symbol.get_rect()
        dsi_surface.blit(temp_symbol, (oil_rect[0] + gauge_width - temp_symbol_rect.width - 15, oil_rect[1] + 35))
        
        # "OIL TEMP" label and symbols (bottom) - moved right to avoid symbol overlap
        oil_temp_label = font_small.render("OIL TEMP", True, text_color)
        oil_temp_label_rect = oil_temp_label.get_rect()
        dsi_surface.blit(oil_temp_label, (oil_rect[0] + (gauge_width - oil_temp_label_rect.width) // 2 + 30, oil_rect[1] + gauge_height - 35))
        
        # Oil symbol and coolant temp symbol from PNG (side by side)
        if oil_symbol and coolant_temp_symbol:
            # Oil symbol (left)
            oil_symbol_x = oil_rect[0] + (gauge_width - oil_temp_label_rect.width) // 2 - 65  # Further left for two symbols
            oil_symbol_y = oil_rect[1] + gauge_height - 55  # Moved up
            scaled_oil_symbol = pygame.transform.scale(oil_symbol, (40, 40))
            dsi_surface.blit(scaled_oil_symbol, (oil_symbol_x, oil_symbol_y))
            
            # Coolant temp symbol (right of oil symbol)
            temp_symbol_x = oil_symbol_x + 45  # 45 pixels to the right
            temp_symbol_y = oil_symbol_y
            scaled_temp_symbol = pygame.transform.scale(coolant_temp_symbol, (40, 40))
            dsi_surface.blit(scaled_temp_symbol, (temp_symbol_x, temp_symbol_y))
    
    # If no switches active, just show empty gauge border
    
    # === 2. GAUGE 2 (Top Right) - Coolant Temperature or Volts ===
    coolant_rect = (DSI_SCREEN_WIDTH - gauge_width - margin, top_margin, gauge_width, gauge_height)
    draw_rounded_rect_border(dsi_surface, border_color, coolant_rect, corner_radius, 3)
    
    if switch_coolant_temp:
        # Show Coolant Temperature Gauge
        if serial_connected:
            coolant_temp = current_coolant_temp  # Use real Arduino data
        elif not was_ever_connected:
            coolant_temp = 115 + math.sin(time_ms * 0.0002) * 135  # Demo: -20 to +250°F (only if never connected)
        else:
            coolant_temp = current_coolant_temp  # Use last known value when disconnected
        
        # Convert temperature for metric display and warning logic
        coolant_temp_celsius = fahrenheit_to_celsius(coolant_temp)
        

        # Determine display temperature and unit
        if switch_metric:
            display_coolant_temp = coolant_temp_celsius
            temp_unit = "°C"
        else:
            display_coolant_temp = coolant_temp
            temp_unit = "°F"
        
        # Warning light for high coolant temperature (between digits and °F/°C)
        if switch_metric:
            warning_light_active = coolant_temp_celsius > fahrenheit_to_celsius(230)  # Convert 230°F threshold to °C
        else:
            warning_light_active = coolant_temp > 230
        if warning_light_active:
            # Blinking red rectangular warning light - same height as digits
            # Stay on most of the time, off briefly
            blink_time = pygame.time.get_ticks() // 200  # Faster cycle (200ms)
            if blink_time % 5 != 0:  # Show light 4 out of 5 cycles (80% on, 20% off)
                digit_height = int(44 * 1.5)  # Same height as 7-segment digits
                warning_rect = (coolant_rect[0] + gauge_width - 80, coolant_rect[1] + 40, 25, digit_height)
                pygame.draw.rect(dsi_surface, RED, warning_rect, 0)
        
        # Temperature digits (left side) - handle "LO" temperature or normal display
        if display_coolant_temp <= -999:  # Special "LO" temperature value from Arduino
            # Display "LO" like original C4 cluster
            lo_font = pygame.font.SysFont('Arial', 48, bold=True)
            lo_text = lo_font.render("LO", True, digit_color)
            lo_rect = lo_text.get_rect()
            dsi_surface.blit(lo_text, (coolant_rect[0] + 30, coolant_rect[1] + 35))
        else:
            # Normal temperature display - 7-segment display with negative sign support and leading zero dimming
            temp_value = int(display_coolant_temp)
            is_negative = temp_value < 0
            abs_temp = abs(temp_value)
            
            digit_size = int(35 * 1.25)  # 44 (25% larger)
            digit_spacing = int(40 * 1.5)  # 60 (50% more spacing)
            # Adjust start position to make room for negative sign
            base_start_x = coolant_rect[0] + 15
            start_x = base_start_x + (25 if is_negative else 0)  # Move digits right if negative
            start_y = coolant_rect[1] + 40
            
            # Draw negative sign if temperature is negative
            if is_negative:
                minus_font = pygame.font.SysFont('Arial', 32, bold=True)  # Larger font for longer minus
                minus_text = minus_font.render("−", True, digit_color)  # Using proper minus symbol (longer)
                dsi_surface.blit(minus_text, (base_start_x + 5, start_y + 12))  # Positioned before digits
            
            draw_dsi_multi_digit_display(dsi_surface, abs_temp, 3, start_x, start_y, digit_spacing, digit_color, digit_size, 0.3)
        
        # Temperature unit symbol (right side)
        temp_symbol = font_medium.render(temp_unit, True, text_color)
        temp_symbol_rect = temp_symbol.get_rect()
        dsi_surface.blit(temp_symbol, (coolant_rect[0] + gauge_width - temp_symbol_rect.width - 15, coolant_rect[1] + 35))
        
        # "COOLANT TEMP" label and thermometer symbol (bottom)
        coolant_label = font_small.render("COOLANT TEMP", True, text_color)
        coolant_label_rect = coolant_label.get_rect()
        dsi_surface.blit(coolant_label, (coolant_rect[0] + (gauge_width - coolant_label_rect.width) // 2, coolant_rect[1] + gauge_height - 35))
        
        # Coolant temperature symbol from PNG
        if coolant_temp_symbol:
            symbol_x = coolant_rect[0] + (gauge_width - coolant_label_rect.width) // 2 - 45  # Moved further left
            symbol_y = coolant_rect[1] + gauge_height - 55  # Moved up
            # Scale the symbol to appropriate size (about 40x40 pixels - 2x larger)
            scaled_symbol = pygame.transform.scale(coolant_temp_symbol, (40, 40))
            dsi_surface.blit(scaled_symbol, (symbol_x, symbol_y))
        else:
            # Fallback: Simple thermometer symbol
            therm_x = coolant_rect[0] + (gauge_width - coolant_label_rect.width) // 2 - 25
            therm_y = coolant_rect[1] + gauge_height - 30
            pygame.draw.circle(dsi_surface, text_color, (therm_x + 3, therm_y + 12), 4, 2)
            pygame.draw.rect(dsi_surface, text_color, (therm_x, therm_y, 6, 12), 2)
    
    elif switch_volts:
        # Show Volts Gauge
        # Use real battery voltage from Arduino
        if serial_connected:
            volts_value = current_battery_voltage
        else:
            volts_value = 12.3  # Demo value (format 00.0)
        
        # Warning light for low voltage (between digits and V)
        warning_light_active = volts_value < 11.0
        if warning_light_active:
            # Blinking red rectangular warning light - same height as digits
            # Stay on most of the time, off briefly
            blink_time = pygame.time.get_ticks() // 200  # Faster cycle (200ms)
            if blink_time % 5 != 0:  # Show light 4 out of 5 cycles (80% on, 20% off)
                digit_height = int(44 * 1.5)  # Same height as 7-segment digits
                # Position between last digit and V symbol - moved right to avoid decimal point overlap
                warning_rect = (coolant_rect[0] + gauge_width - 60, coolant_rect[1] + 40, 25, digit_height)
                pygame.draw.rect(dsi_surface, RED, warning_rect, 0)
        
        # Voltage digits (left side) - 7-segment display (format: 00.0) with leading zero dimming
        digit_size = int(35 * 1.25)  # 44 (25% larger)
        digit_spacing = int(40 * 1.5)  # 60 (50% more spacing)
        start_x = coolant_rect[0] + 15
        start_y = coolant_rect[1] + 40
        
        draw_dsi_multi_digit_display(dsi_surface, volts_value, 3, start_x, start_y, digit_spacing, digit_color, digit_size, 0.3, decimal_pos=2)
        
        # V symbol (right side)
        volts_symbol = font_medium.render("V", True, text_color)
        volts_symbol_rect = volts_symbol.get_rect()
        dsi_surface.blit(volts_symbol, (coolant_rect[0] + gauge_width - volts_symbol_rect.width - 15, coolant_rect[1] + 35))
        
        # "VOLTS" label and battery symbol (bottom)
        volts_label = font_small.render("VOLTS", True, text_color)
        volts_label_rect = volts_label.get_rect()
        dsi_surface.blit(volts_label, (coolant_rect[0] + (gauge_width - volts_label_rect.width) // 2, coolant_rect[1] + gauge_height - 35))
        
        # Battery symbol from PNG
        if battery_symbol:
            symbol_x = coolant_rect[0] + (gauge_width - volts_label_rect.width) // 2 - 45  # Moved further left
            symbol_y = coolant_rect[1] + gauge_height - 55  # Moved up
            # Scale the symbol to appropriate size (about 40x40 pixels - 2x larger)
            scaled_symbol = pygame.transform.scale(battery_symbol, (40, 40))
            dsi_surface.blit(scaled_symbol, (symbol_x, symbol_y))
        else:
            # Fallback: Simple battery symbol (rectangle)
            battery_x = coolant_rect[0] + (gauge_width - volts_label_rect.width) // 2 - 25
            battery_y = coolant_rect[1] + gauge_height - 30
            pygame.draw.rect(dsi_surface, text_color, (battery_x, battery_y, 16, 10), 2)
            pygame.draw.rect(dsi_surface, text_color, (battery_x + 16, battery_y + 3, 3, 4), 2)
    
    # If no switches active, just show empty gauge border
    
    # === 3. GAUGE 3 (Bottom Left) - Range or Trip Odometer ===
    range_rect = (margin, DSI_SCREEN_HEIGHT - gauge_height - bottom_margin, gauge_width, gauge_height)
    # No border for gauge 3
    
    if switch_fuel_range:
        # Show Range Gauge (remove "TRIP" from "RANGE TRIP")
        if serial_connected:
            range_miles = current_fuel_range  # Use real Arduino data
        elif not was_ever_connected:
            range_miles = 275 + math.sin(time_ms * 0.0002) * 275  # Demo: 0-550 miles (only if never connected)
        else:
            range_miles = current_fuel_range  # Use last known value when disconnected
        
        # "RANGE" title (top) - removed "TRIP"
        range_title = font_small.render("RANGE", True, text_color)
        range_title_rect = range_title.get_rect()
        dsi_surface.blit(range_title, (range_rect[0] + (gauge_width - range_title_rect.width) // 2, range_rect[1] + 35))
        
        # Distance unit label (bottom)
        if switch_metric:
            range_km = miles_to_km(range_miles)
            distance_text = font_medium.render("KM", True, text_color)
            display_range = range_km
        else:
            distance_text = font_medium.render("MILES", True, text_color)
            display_range = range_miles
        distance_text_rect = distance_text.get_rect()
        dsi_surface.blit(distance_text, (range_rect[0] + (gauge_width - distance_text_rect.width) // 2, range_rect[1] + gauge_height - 35))
        
        # Range digits (right side) - format 000.0 - 7-segment display with leading zero dimming
        digit_size = int(28 * 1.25)  # 35 (25% larger)
        digit_spacing = int(32 * 1.5)  # 48 (50% more spacing)
        total_width = 4 * digit_spacing + 35  # 4 digits plus decimal point space
        start_x = range_rect[0] + gauge_width - total_width - 10
        start_y = range_rect[1] + 75
        
        draw_dsi_multi_digit_display(dsi_surface, display_range, 4, start_x, start_y, digit_spacing, digit_color, digit_size, 0.3, decimal_pos=3)
    
    elif switch_trip_odo:
        # Show Trip Odometer Gauge
        if serial_connected:
            trip_miles = persistent_data.data["trip_odometer"]  # Use Pi's trip data directly
        elif not was_ever_connected:
            trip_miles = 123.4 + math.sin(time_ms * 0.0003) * 50  # Demo: 73-173 miles (only if never connected)
        else:
            trip_miles = persistent_data.data["trip_odometer"]  # Use Pi's trip data when disconnected
        
        # "TRIP ODO" title (top)
        trip_title = font_small.render("TRIP ODO", True, text_color)
        trip_title_rect = trip_title.get_rect()
        dsi_surface.blit(trip_title, (range_rect[0] + (gauge_width - trip_title_rect.width) // 2, range_rect[1] + 35))
        
        # Distance unit label (bottom)
        if switch_metric:
            trip_km = miles_to_km(trip_miles)
            distance_text = font_medium.render("KM", True, text_color)
            display_trip = trip_km
        else:
            distance_text = font_medium.render("MILES", True, text_color)
            display_trip = trip_miles
        distance_text_rect = distance_text.get_rect()
        dsi_surface.blit(distance_text, (range_rect[0] + (gauge_width - distance_text_rect.width) // 2, range_rect[1] + gauge_height - 35))
        
        # Trip digits (right side) - format 000.0 - 7-segment display with leading zero dimming
        digit_size = int(28 * 1.25)  # 35 (25% larger)
        digit_spacing = int(32 * 1.5)  # 48 (50% more spacing)
        total_width = 4 * digit_spacing + 35  # 4 digits plus decimal point space
        start_x = range_rect[0] + gauge_width - total_width - 10
        start_y = range_rect[1] + 75
        
        draw_dsi_multi_digit_display(dsi_surface, display_trip, 4, start_x, start_y, digit_spacing, digit_color, digit_size, 0.3, decimal_pos=3)
    
    # If no switches active, just show empty gauge area
    
    # === 4. GAUGE 4 (Bottom Right) - Instant MPG or Average MPG ===
    mpg_rect = (DSI_SCREEN_WIDTH - gauge_width - margin, DSI_SCREEN_HEIGHT - gauge_height - bottom_margin, gauge_width, gauge_height)
    # No border for gauge 4
    
    if switch_inst_mpg:
        # Show Instant MPG Gauge
        if serial_connected:
            instant_mpg = current_inst_mpg  # Use real Arduino data
        elif not was_ever_connected:
            instant_mpg = 25 + math.sin(time_ms * 0.0004) * 25  # Demo: 0-50 MPG (only if never connected)
        else:
            instant_mpg = current_inst_mpg  # Use last known value when disconnected
        
        # "INSTANT" title (top)
        instant_title = font_small.render("INSTANT", True, text_color)
        instant_title_rect = instant_title.get_rect()
        dsi_surface.blit(instant_title, (mpg_rect[0] + (gauge_width - instant_title_rect.width) // 2, mpg_rect[1] + 35))
        
        # Handle special instant MPG values from Arduino
        digit_size = int(28 * 1.25)  # 35 (25% larger)
        digit_spacing = int(32 * 1.5)  # 48 (50% more spacing)
        start_x = mpg_rect[0] + 15
        start_y = mpg_rect[1] + 75
        
        if instant_mpg == 0.0:
            # Engine idling - show GPH using real fuel flow data
            if current_fuel_flow_gph > 0.01:  # Use real data if available
                gph_value = current_fuel_flow_gph
            else:
                gph_value = 0.8  # Fallback estimate for idling
            
            # Display GPH value using DSEG format (same as other DSI gauges)
            draw_dsi_multi_digit_display(dsi_surface, gph_value, 3, start_x, start_y, digit_spacing, digit_color, digit_size, 0.3, decimal_pos=2)
        elif instant_mpg == -1.0:
            # Engine off - show "OFF"
            off_font = pygame.font.SysFont('Arial', 32, bold=True)
            off_text = off_font.render("OFF", True, (128, 128, 128))  # Gray color for OFF
            off_rect = off_text.get_rect()
            dsi_surface.blit(off_text, (start_x + 25, start_y + 10))
        else:
            # Normal MPG display (positive values only)
            if instant_mpg > 0:  # Only display positive MPG values
                if switch_metric:
                    instant_lp100km = mpg_to_lp100km(instant_mpg)
                    display_instant = instant_lp100km
                else:
                    display_instant = instant_mpg
                
                draw_dsi_multi_digit_display(dsi_surface, display_instant, 3, start_x, start_y, digit_spacing, digit_color, digit_size, 0.3, decimal_pos=2)
            else:
                # Handle unexpected negative values - show "---"
                dash_font = pygame.font.SysFont('Arial', 32, bold=True)
                dash_text = dash_font.render("---", True, (128, 128, 128))
                dsi_surface.blit(dash_text, (start_x + 25, start_y + 10))
        
        # Fuel economy unit label (under the digits)
        if instant_mpg == 0.0:
            # Show "GPH" when idling
            fuel_econ_text = font_medium.render("GPH", True, text_color)
        elif switch_metric:
            fuel_econ_text = font_medium.render("L/100km", True, text_color)
        else:
            fuel_econ_text = font_medium.render("MPG", True, text_color)
        fuel_econ_text_rect = fuel_econ_text.get_rect()
        dsi_surface.blit(fuel_econ_text, (mpg_rect[0] + (gauge_width - fuel_econ_text_rect.width) // 2, mpg_rect[1] + gauge_height - 35))
    
    elif switch_avg_mpg:
        # Show Average MPG Gauge
        if serial_connected:
            avg_mpg = current_avg_mpg  # Use real Arduino data
        elif not was_ever_connected:
            avg_mpg = 22.3 + math.sin(time_ms * 0.0003) * 8  # Demo: 14-30 MPG (only if never connected)
        else:
            avg_mpg = current_avg_mpg  # Use last known value when disconnected
        
        # "AVERAGE" title (top)
        avg_title = font_small.render("AVERAGE", True, text_color)
        avg_title_rect = avg_title.get_rect()
        dsi_surface.blit(avg_title, (mpg_rect[0] + (gauge_width - avg_title_rect.width) // 2, mpg_rect[1] + 35))
        
        # Fuel economy digits (left side) - format 00.0 - 7-segment display with leading zero dimming
        if switch_metric:
            avg_lp100km = mpg_to_lp100km(avg_mpg)
            display_avg = avg_lp100km
        else:
            display_avg = avg_mpg
        digit_size = int(28 * 1.25)  # 35 (25% larger)
        digit_spacing = int(32 * 1.5)  # 48 (50% more spacing)
        start_x = mpg_rect[0] + 15
        start_y = mpg_rect[1] + 75
        
        draw_dsi_multi_digit_display(dsi_surface, display_avg, 3, start_x, start_y, digit_spacing, digit_color, digit_size, 0.3, decimal_pos=2)
        
        # Fuel economy unit label (under the digits)
        if switch_metric:
            fuel_econ_text = font_medium.render("L/100km", True, text_color)
        else:
            fuel_econ_text = font_medium.render("MPG", True, text_color)
        fuel_econ_text_rect = fuel_econ_text.get_rect()
        dsi_surface.blit(fuel_econ_text, (mpg_rect[0] + (gauge_width - fuel_econ_text_rect.width) // 2, mpg_rect[1] + gauge_height - 35))
    else:
        # If no switches active, just show empty gauge area
        pass
    
    # === 5. FUEL LEVEL GAUGE (Center, vertical bar of ticks) ===
    fuel_center_x = DSI_SCREEN_WIDTH // 2
    fuel_y_start = top_margin + 20  # Use adjusted top margin
    fuel_y_end = DSI_SCREEN_HEIGHT - bottom_margin - 80  # Use adjusted bottom margin
    fuel_height = fuel_y_end - fuel_y_start
    
    # Fuel level (real Arduino data or demo - 0.0 to 1.0)
    if serial_connected:
        fuel_level = current_fuel_level / 100.0  # Convert percentage to 0.0-1.0 range
    elif not was_ever_connected:
        fuel_level = 0.5 + math.sin(time_ms * 0.0001) * 0.5  # Demo: 0-100% full (only if never connected)
    else:
        fuel_level = current_fuel_level / 100.0  # Use last known value when disconnected
    
    # Draw fuel level ticks as horizontal bars (like speedometer) - higher resolution
    tick_count = 17  # More ticks for better resolution (every 1/16th)
    # Define which ticks get labels (every 4th tick: 0, 4, 8, 12, 16 = E, 1/4, 1/2, 3/4, F)
    tick_labels = ["E", "", "", "", "1/4", "", "", "", "1/2", "", "", "", "3/4", "", "", "", "F"]
    
    for i in range(tick_count):
        # Calculate position from bottom to top (E at bottom, F at top)
        tick_y = fuel_y_end - (i / (tick_count - 1)) * fuel_height
        fuel_ratio = i / (tick_count - 1)  # 0.0 to 1.0
        
        # Determine tick properties based on fuel level
        # Add small tolerance for floating-point precision (fixes 100% display issue)
        if fuel_ratio <= (fuel_level + 0.001):
            # Active ticks (fuel present)
            if fuel_ratio < 0.1:  # Very low fuel - red
                tick_color = RED
            elif fuel_ratio < 0.25:  # Low fuel - orange
                tick_color = ORANGE
            else:  # Normal fuel - green
                tick_color = BRIGHT_GREEN
        else:
            # Inactive ticks (no fuel)
            if fuel_ratio < 0.1:
                tick_color = (100, 0, 0)  # Dim red
            elif fuel_ratio < 0.25:
                tick_color = (100, 50, 0)  # Dim orange
            else:
                tick_color = DULL_GREEN  # Dim green
        
        # All ticks same length and 25% longer
        tick_width = int(80 * 1.25)  # 100px (25% longer)
        tick_thickness = 12  # Reduced thickness for better fit in window (was 16)
        
        # Calculate tick position (centered)
        tick_start_x = fuel_center_x - tick_width // 2
        tick_end_x = fuel_center_x + tick_width // 2
        
        # Draw thick horizontal tick (like speedometer)
        pygame.draw.line(dsi_surface, tick_color, 
                        (tick_start_x, tick_y), 
                        (tick_end_x, tick_y), 
                        tick_thickness)
        
        # Draw label if exists (to the left of the tick with dash)
        if tick_labels[i]:
            label_color = YELLOW if fuel_ratio <= fuel_level else (80, 80, 0)
            label_text = font_small.render(tick_labels[i], True, label_color)
            label_rect = label_text.get_rect()
            
            # Position label to the left of tick
            label_x = tick_start_x - label_rect.width - 20  # More space for dash
            label_y = tick_y - label_rect.height // 2
            dsi_surface.blit(label_text, (label_x, label_y))
            
            # Draw small yellow dash between label and tick
            dash_x = tick_start_x - 12  # Position dash between label and tick
            dash_y = tick_y
            pygame.draw.line(dsi_surface, YELLOW, (dash_x - 6, dash_y), (dash_x, dash_y), 3)
    
    # "RESERVE" warning (only if fuel is very low)
    if fuel_level < 0.1:
        reserve_text = font_medium.render("RESERVE", True, RED)
        reserve_rect = reserve_text.get_rect()
        dsi_surface.blit(reserve_text, (fuel_center_x - reserve_rect.width // 2, fuel_y_end + 20))
    
    # "UNLEADED FUEL ONLY" text and fuel pump symbol (bottom) - hide when RESERVE warning is showing
    if fuel_level >= 0.1:  # Only show when NOT in reserve (same condition as reserve warning but inverted)
        fuel_text1 = font_small.render("UNLEADED", True, text_color)
        fuel_text2 = font_small.render("FUEL ONLY", True, text_color)
        
        fuel_text1_rect = fuel_text1.get_rect()
        fuel_text2_rect = fuel_text2.get_rect()
        
        text_y = DSI_SCREEN_HEIGHT - bottom_margin - 50  # Moved up 15px more (was -35, now -50)
        # Center the text under the fuel gauge
        dsi_surface.blit(fuel_text1, (fuel_center_x - fuel_text1_rect.width // 2, text_y))
        dsi_surface.blit(fuel_text2, (fuel_center_x - fuel_text2_rect.width // 2, text_y + 20))
        
        # Gas pump symbol from PNG (to the left of the text)
        if gas_pump_symbol:
            symbol_x = fuel_center_x - 100  # Moved further left
            symbol_y = text_y - 15  # Moved up
            # Scale the symbol to appropriate size (about 50x50 pixels - 2x larger)
            scaled_symbol = pygame.transform.scale(gas_pump_symbol, (50, 50))
            dsi_surface.blit(scaled_symbol, (symbol_x, symbol_y))
        else:
            # Fallback: More realistic gas pipe symbol
            pipe_x = fuel_center_x - 80
            pipe_y = text_y + 8
            # Main vertical pipe
            pygame.draw.rect(dsi_surface, text_color, (pipe_x, pipe_y - 5, 4, 15), 0)
            # Horizontal connector
            pygame.draw.rect(dsi_surface, text_color, (pipe_x + 4, pipe_y + 2, 12, 4), 0)
            # Nozzle tip
            pygame.draw.rect(dsi_surface, text_color, (pipe_x + 16, pipe_y + 1, 8, 6), 0)
            # Handle
            pygame.draw.rect(dsi_surface, text_color, (pipe_x - 2, pipe_y - 8, 8, 3), 0)
    
    # DSI content is now drawn directly on the passed surface
    # No need to blit since we're using the surface parameter directly

print("C4 Corvette Dashboard - Triple Display System")
print(f"Arduino: {SERIAL_PORT} @ {SERIAL_BAUD} baud - {'Connected' if serial_connected else 'Demo Mode'}")
print("Press ESC to exit | F11 for fullscreen")

# Signal handler for graceful shutdown
def signal_handler(signum, frame):
    """Handle SIGTERM and SIGINT for graceful shutdown"""
    global running
    running = False

# Register signal handlers
signal.signal(signal.SIGTERM, signal_handler)
signal.signal(signal.SIGINT, signal_handler)

# ===== CITROËN BX STYLE FUNCTIONS =====
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
