yahor-chupin/corvette-c4-raspberry-dashboard/(commit log)

2025-11-12 adding wiring diagram
2025-11-12 adding support button
2026-02-04 replacing Arduino switch pins (debug)
2026-02-08 fixing button timing issues
    [arduino_code.cpp, arduino_combined_dashboard.py]
